e21199-eng/fyp-mechanosensor/docs/final_setup.jpeg

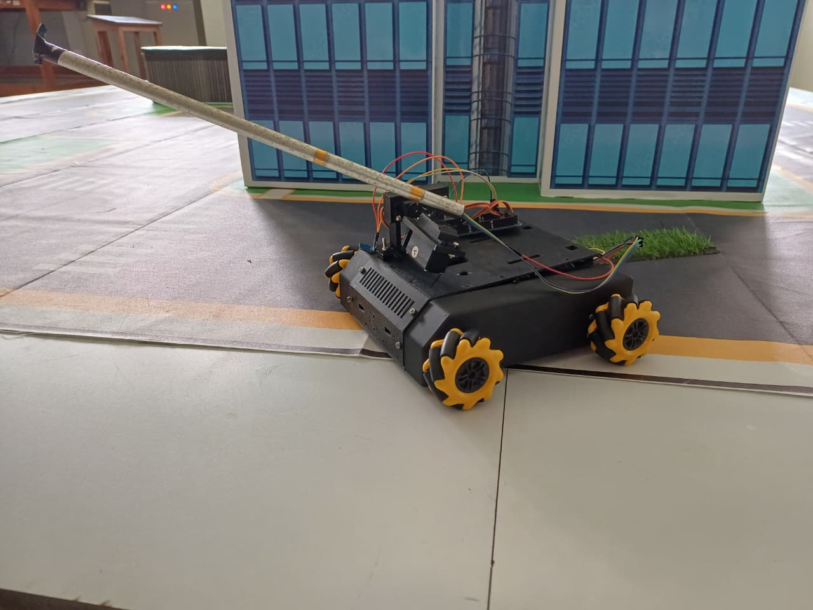
docs/final_setup.jpeg
