e21199-eng/fyp-mechanosensor/docs/assembled.jpeg

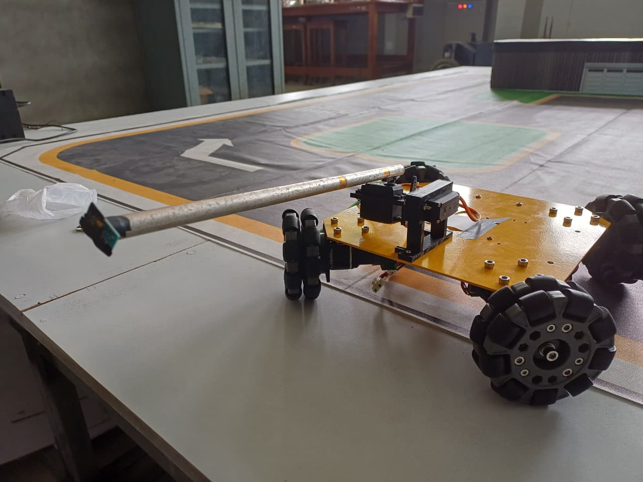
docs/assembled.jpeg
