e21199-eng/fyp-mechanosensor/README.md

# FYP Portfolio — Ego-Motion Cancellation in Vibration-Based Mechanosensors

> **Final Year Project** | Department of Engineering | 2024/2025

---

## 🤖 Project Description

In this project, a **vibration-based artificial robotic antenna**, inspired by insect antennae, is constructed using an **accelerometer mounted on the tip of a plastic tube**, and is used for detecting contacts.

The antenna is mounted on a **Pan-Tilt unit** which is then attached to a **mobile robot platform**. The key problem with this type of mechanosensor is **self-sensing due to ego-motion** vibrations from the robot's own movement interfere with contact detection. The aim is to **cancel the effects of ego-motion** using a **bio-inspired algorithm**.

---

## 🌐 Live Portfolio

👉 **[View Portfolio Website](https://e21199-eng.github.io/fyp-mechanosensor/)**

*(Replace with your actual GitHub Pages link after deploying)*

---

## 📅 Project Timeline (14 Weeks)

| Activity | Weeks |
|---|---|
| Literature Review | Week 1–2 |
| Component Research & Acquisition | Week 3 |
| Hardware Design & Schematic Drafting | Week 4–5 |
| Coding & Logic Framework Development | Week 6–9 |
| Hardware Assembly & Integration | Week 7–9 |
| Hardware Calibration | Week 10–11 |
| Offline Data Testing & Model Training | Week 11–12 |
| Performance Evaluation & Refinement | Week 13–14 |

---

## 📦 Deliverables

| # | Deliverable | Due |
|---|---|-----|
| 1 | Literature Review Summary | Week 3 |
| 2 | Hardware Components & Procurement List | Week 4 |
| 3 | PCB Schematics & Design Files | Week 6 |
| 4 | Initial Coding Framework | Week 9 |
| 5 | Assembled Mechanosensor Prototype | Week 10 |
| 6 | Calibration & Sensitivity Report | Week 11 |
| 7 | Offline Testing Analysis Report | Week 14 |

---

## 🗂️ Repository Structure

```
fyp-portfolio/
├── index.html          ← Main portfolio website
├── css/
│   ├── style.css       ← Custom styles
│   └── bootstrap.min.css
├── js/
│   └── main.js         ← Custom scripts
├── img/                ← Add your project images here
├── lib/                ← Animation & UI libraries
└── README.md
```

---

## 🚀 How to Deploy on GitHub Pages

1. Push this folder to your GitHub repository
2. Go to **Settings → Pages**
3. Source: **Deploy from branch → main → / (root)**
4. Your site will be live at: `https://YOUR_USERNAME.github.io/REPO_NAME/`

---

## 🛠️ How to Update Weekly Progress

Each week, open `index.html` and find the **Weekly Updates** section.

Change the status of each week's card:
- `status-completed` — work done ✅
- `status-inprogress` — currently working 🔄
- `status-upcoming` — not started yet ⏳

Update the description text inside each `.update-body` section.

---

## 📸 Adding Your Own Images

Replace placeholder divs in `index.html` with real images:

```html
<!-- Find this comment in index.html: -->
<!-- Replace the div above with: <img class="w-100" src="img/robot-antenna.jpg" ...> -->

<!-- Simply add your image to the img/ folder and update the src path -->
```

---

## 📬 Contact

| Jayasundara J.P. | E/21/199 |
| Divyanga D.H.S. | E/21/117 |
| Kariyawasam N.G.V.K. | E/21/212 |

**Supervisors:** Dr. B.G.L.T. Samaranayake, Dr. W.A.N.I. Harischandra
**University:** University of Peradeniya — Faculty of Engineering
**Email:** e21199@eng.pdn.ac.lk

---

*Portfolio built using the Coraluxe HTML template, adapted for FYP use.*
