e21199-eng/fyp-mechanosensor/docs/accelerometer_data.jpeg

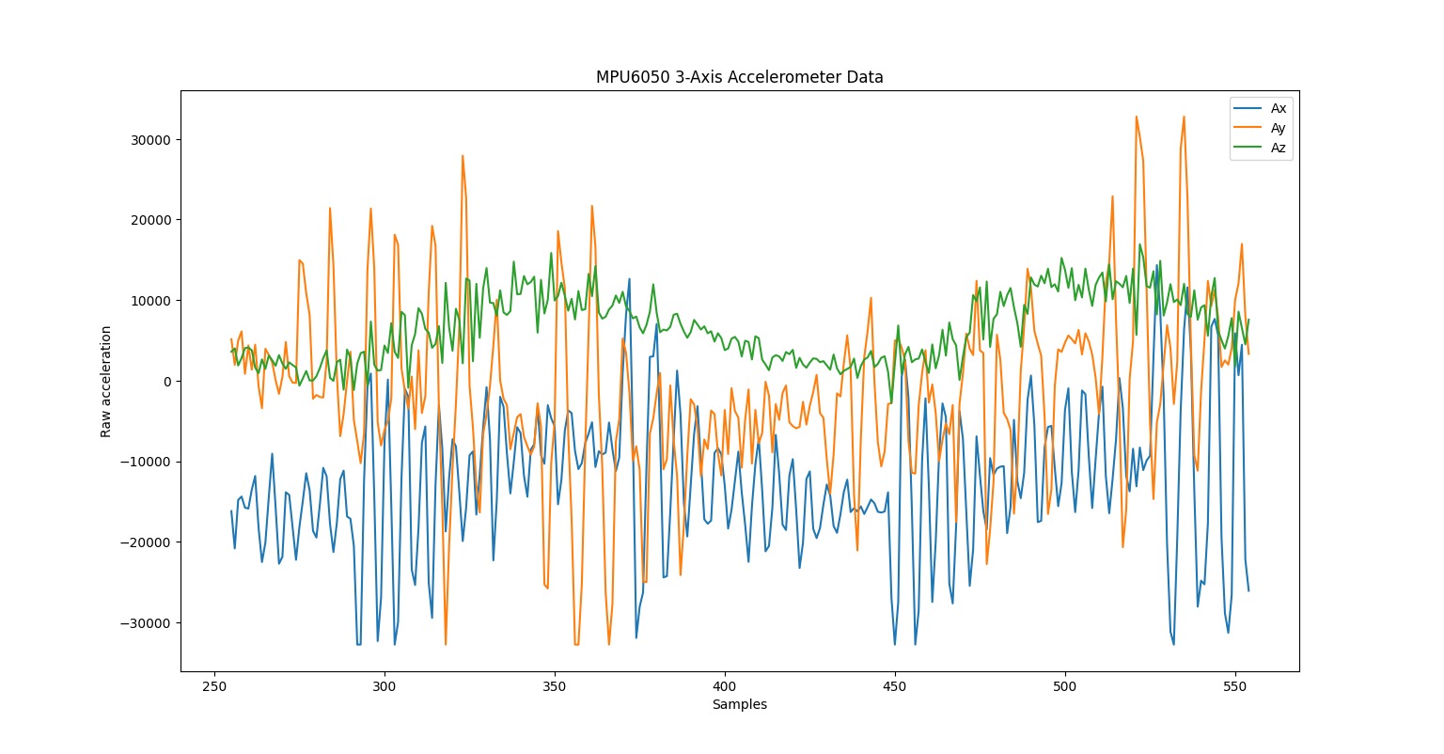
docs/accelerometer_data.jpeg
