e21199-eng/fyp-mechanosensor/docs/accelometer.jpeg

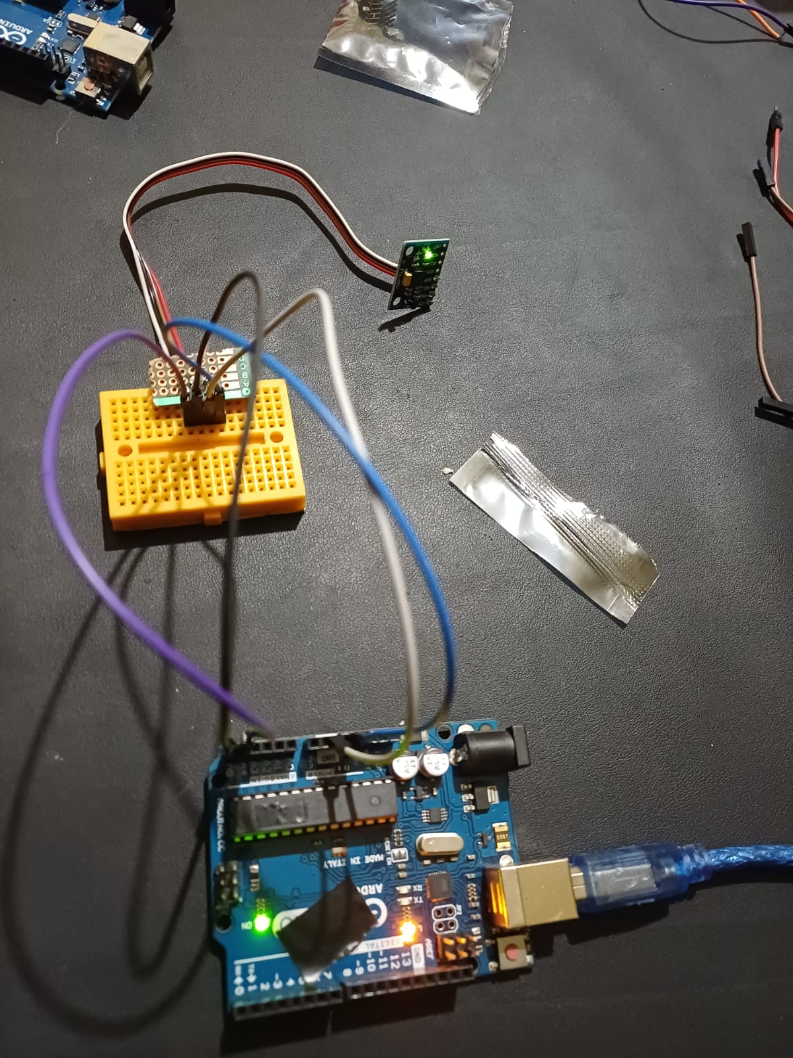
docs/accelometer.jpeg
