e21199-eng/fyp-mechanosensor/docs/Cct Diagram.jpeg

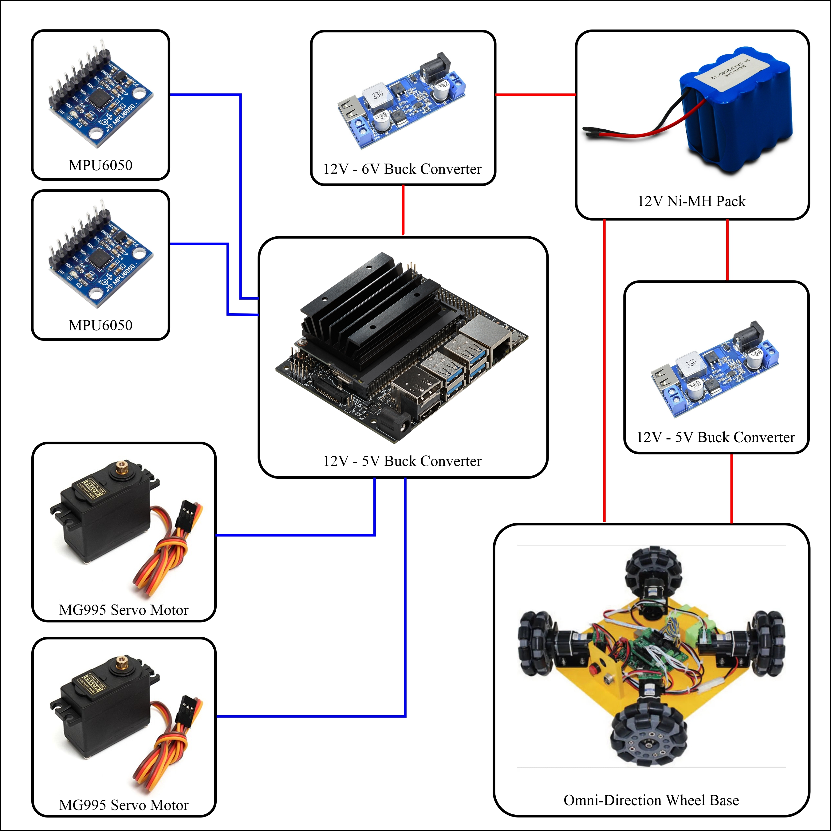
docs/Cct Diagram.jpeg
