e21199-eng/fyp-mechanosensor/docs/circuit.jpeg

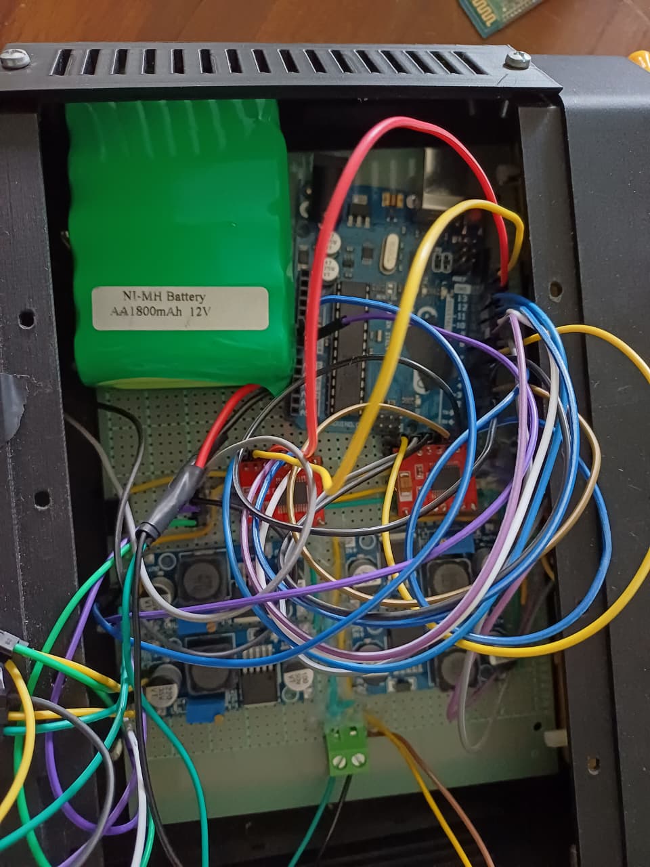
docs/circuit.jpeg
