e21199-eng/fyp-mechanosensor/docs/Circuit_Dia.jpeg

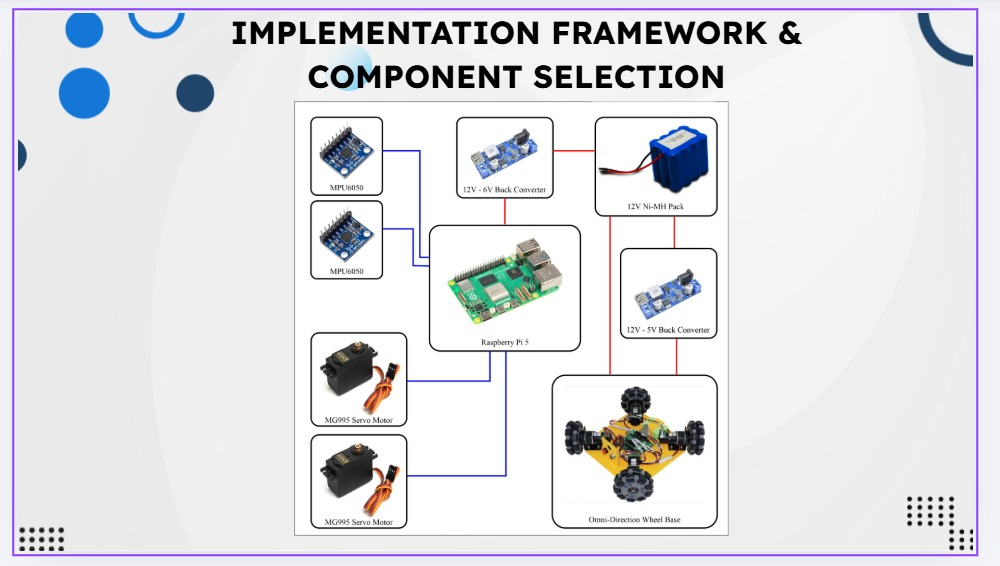
docs/Circuit_Dia.jpeg
