e21199-eng/fyp-mechanosensor/docs/Data_flow.jpeg

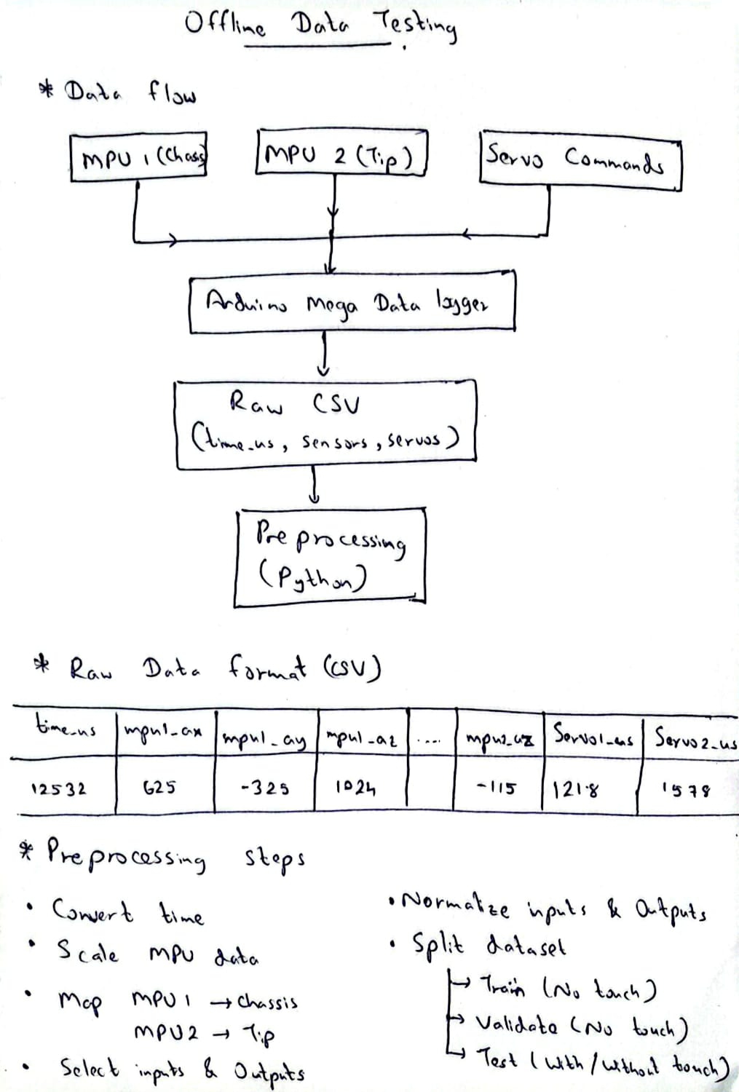
docs/Data_flow.jpeg
