e21199-eng/fyp-mechanosensor/docs/ESN1.jpeg

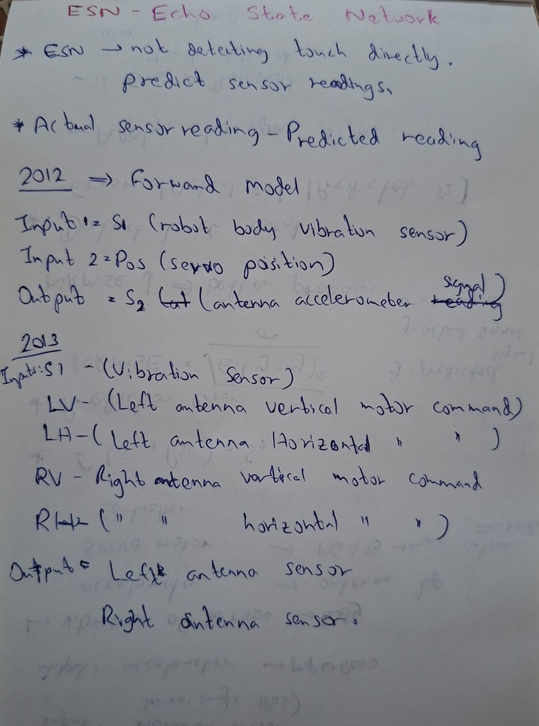
docs/ESN1.jpeg
