e21199-eng/fyp-mechanosensor/docs/ESN2.jpeg

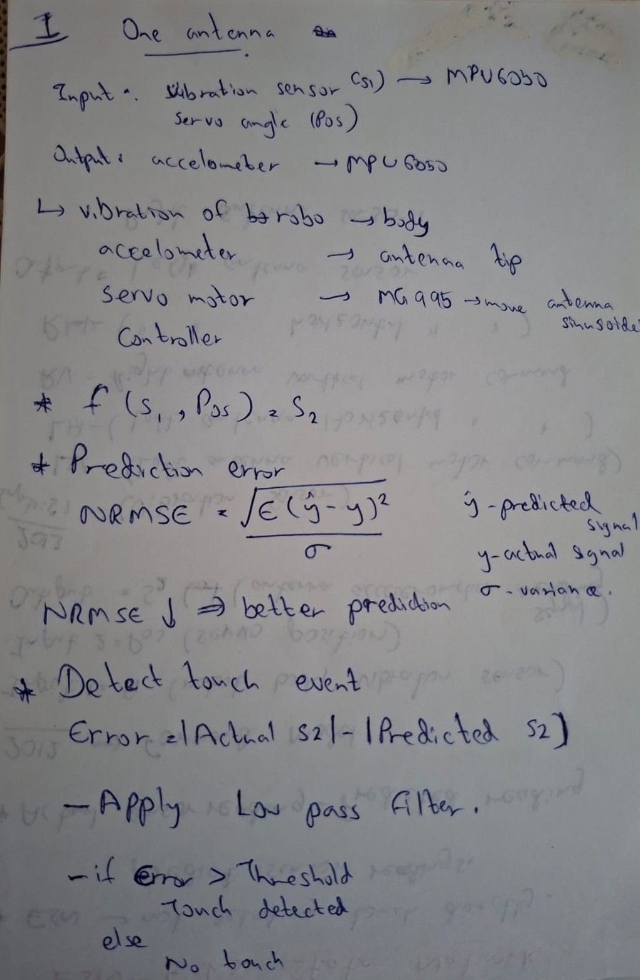
docs/ESN2.jpeg
