e21199-eng/fyp-mechanosensor/docs/ESN3.jpeg

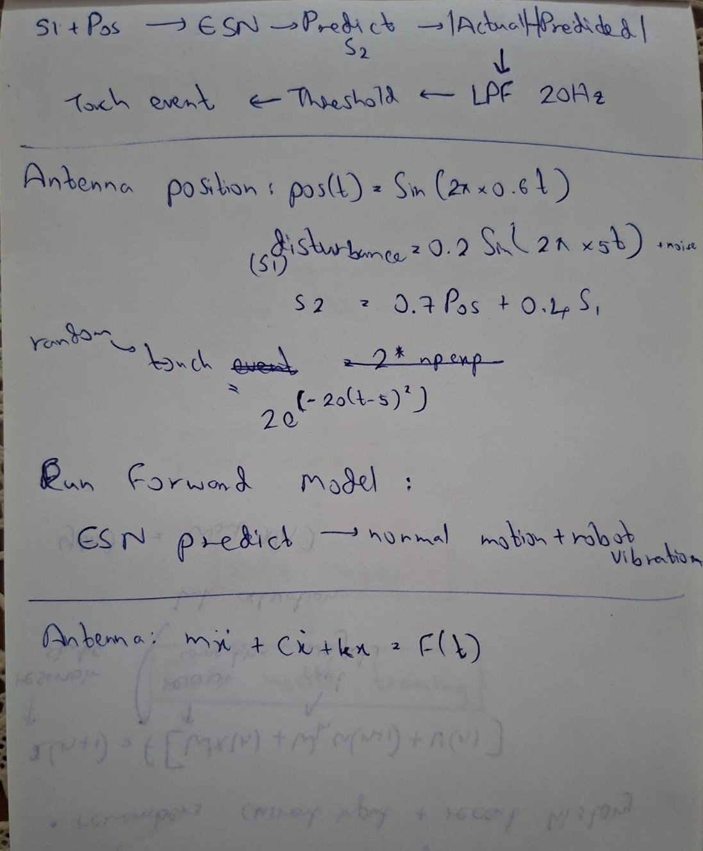
docs/ESN3.jpeg
