e21199-eng/fyp-mechanosensor/docs/esn.png

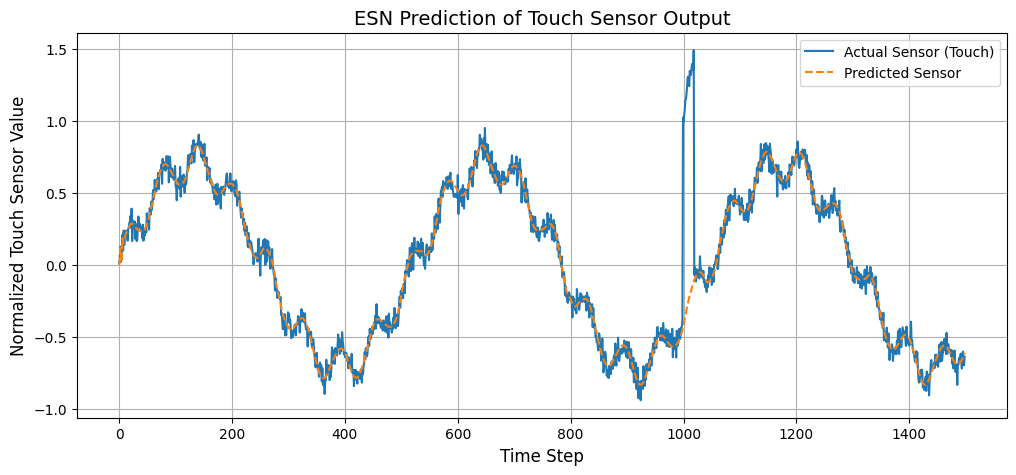
docs/esn.png
