e21199-eng/fyp-mechanosensor/docs/Hyperparameters.jpeg

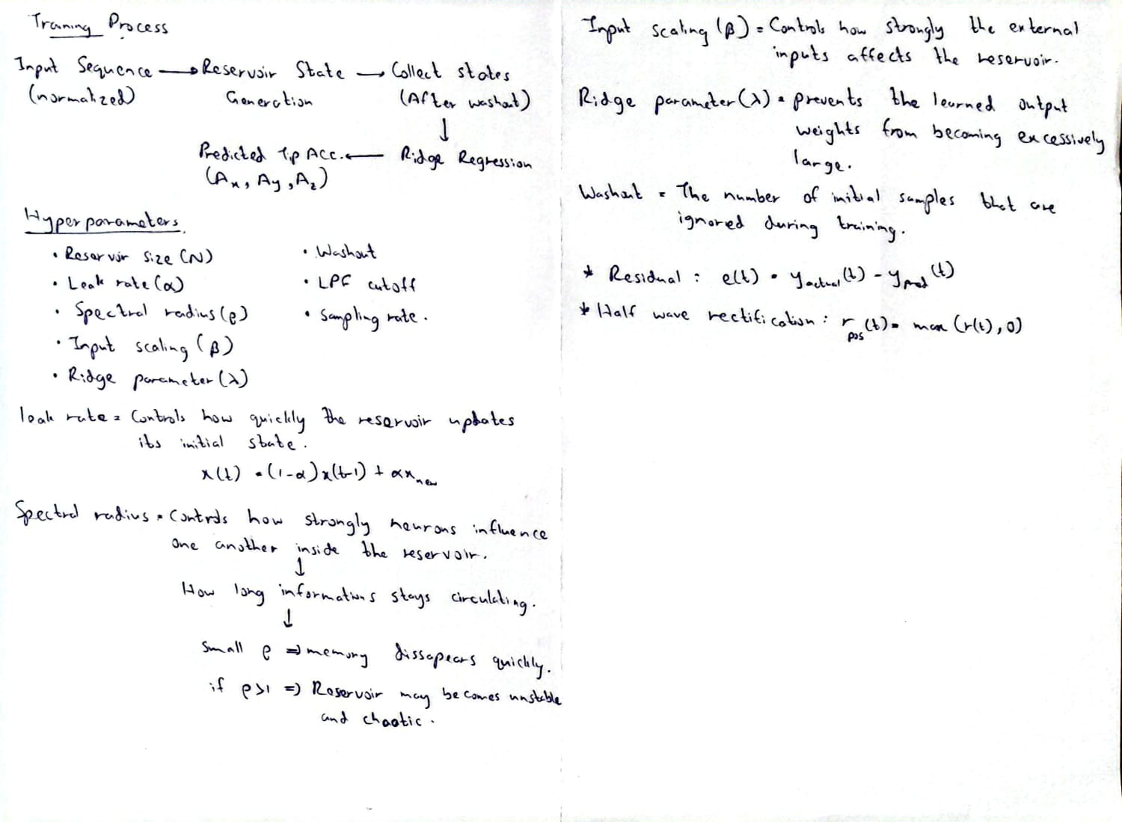
docs/Hyperparameters.jpeg
