e21199-eng/fyp-mechanosensor/docs/Kalman.jpeg

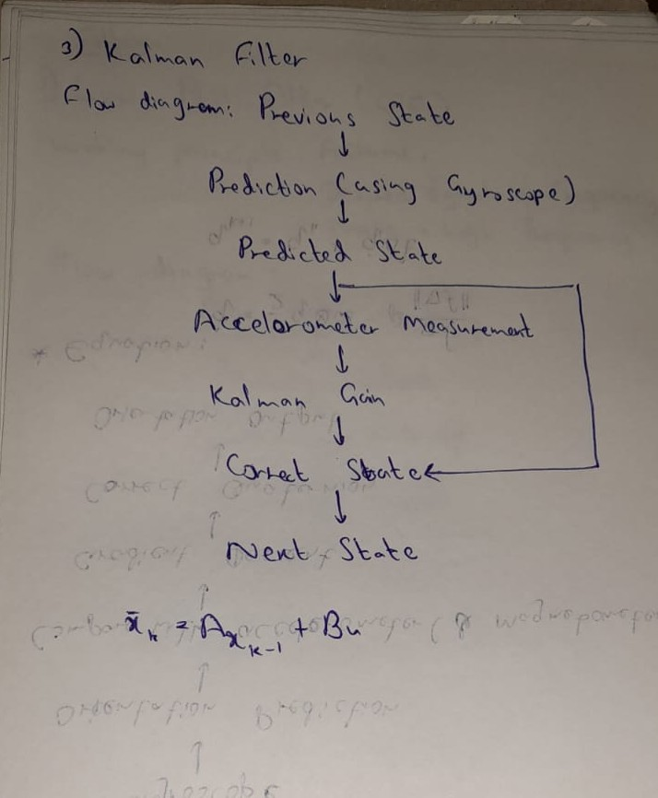
docs/Kalman.jpeg
