e21199-eng/fyp-mechanosensor/docs/LPF.jpeg

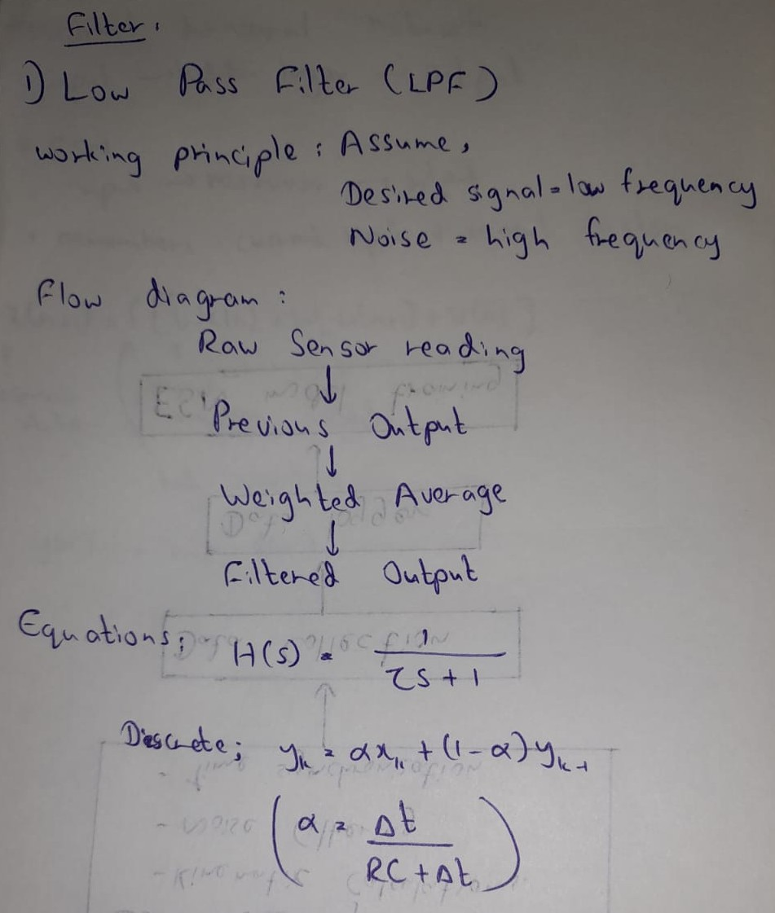
docs/LPF.jpeg
