e21199-eng/fyp-mechanosensor/docs/Madgwick.jpeg

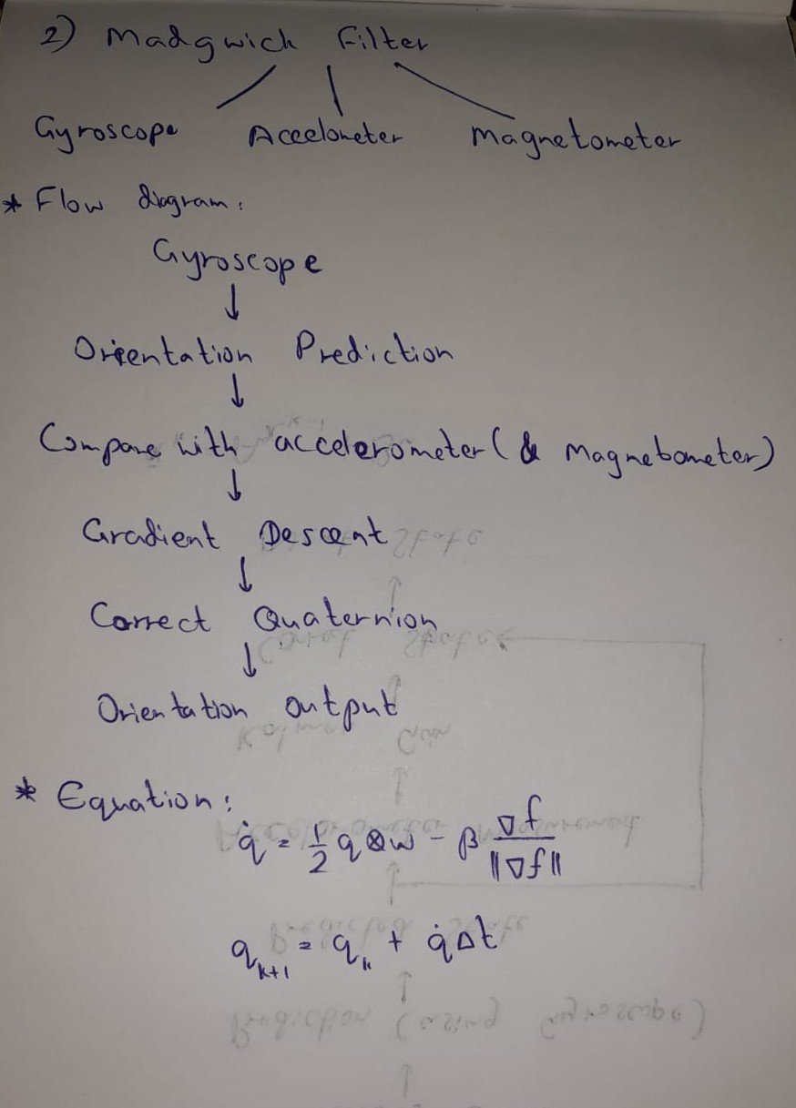
docs/Madgwick.jpeg
