e21199-eng/fyp-mechanosensor/docs/powerlines.jpeg

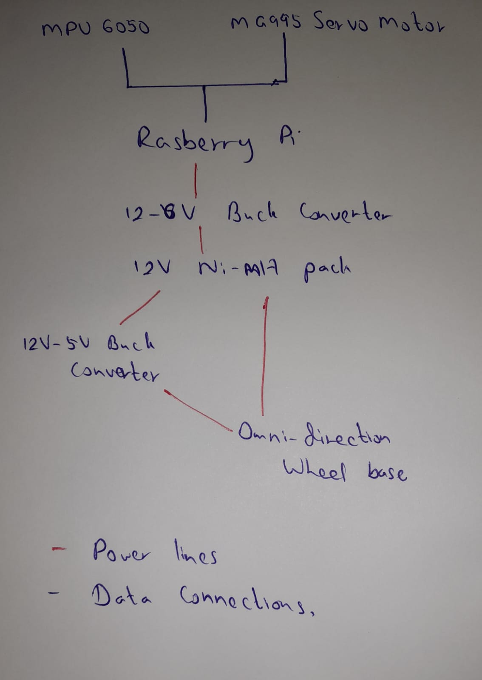
docs/powerlines.jpeg
