e21199-eng/fyp-mechanosensor/docs/Structure.jpeg

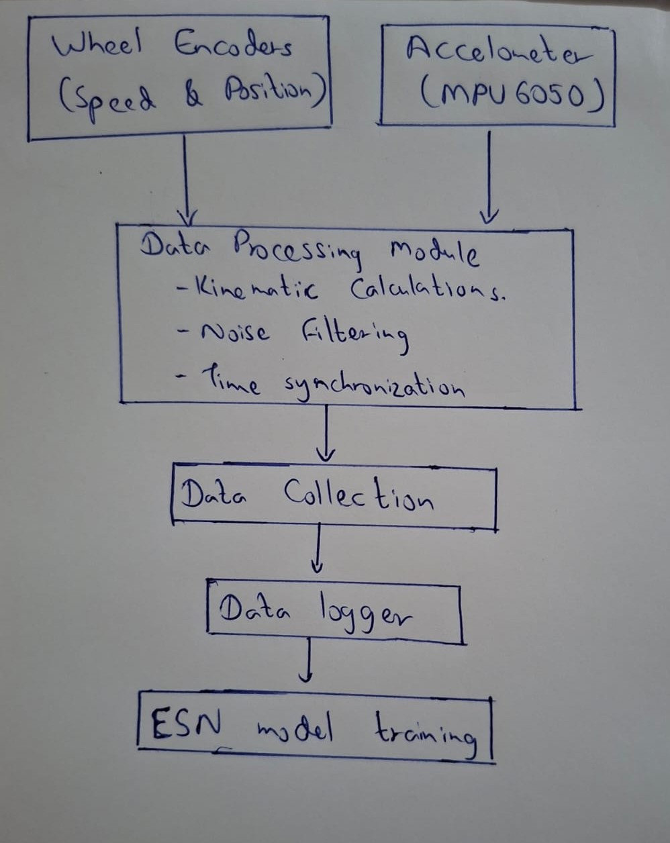
docs/Structure.jpeg
