e21199-eng/fyp-mechanosensor/hero1.jpg

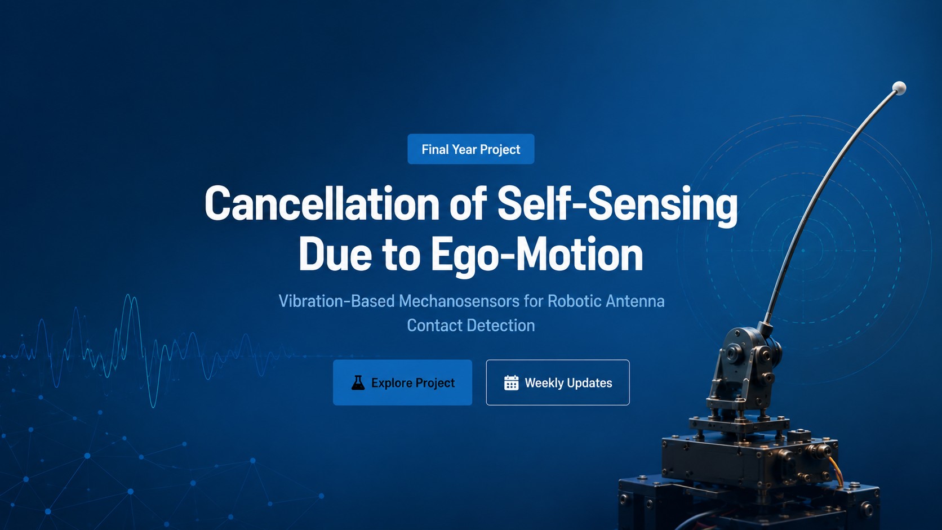
hero1.jpg
