e21199-eng/fyp-mechanosensor/hero2.jpg

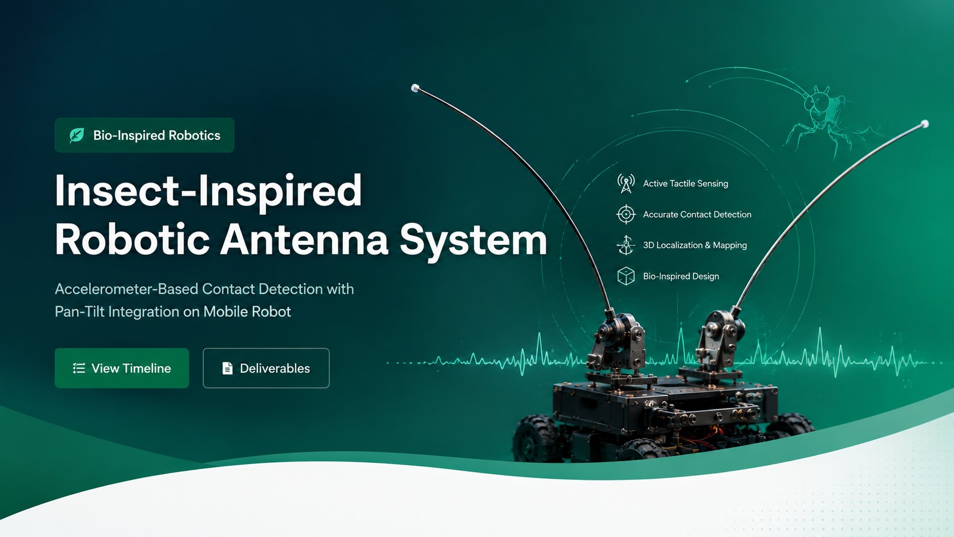
hero2.jpg
