e21199-eng/fyp-mechanosensor/member1.jpg

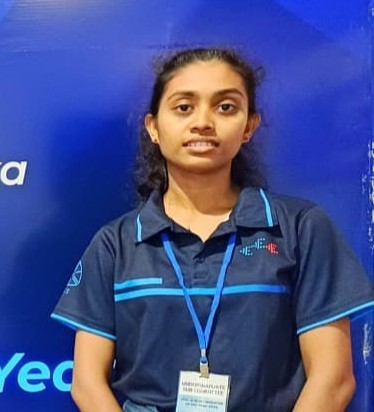
member1.jpg
