e21199-eng/fyp-mechanosensor/member2.jpg

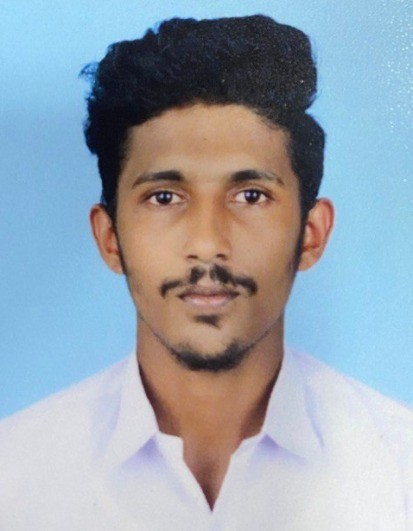
member2.jpg
