e21199-eng/fyp-mechanosensor/member3.jpg

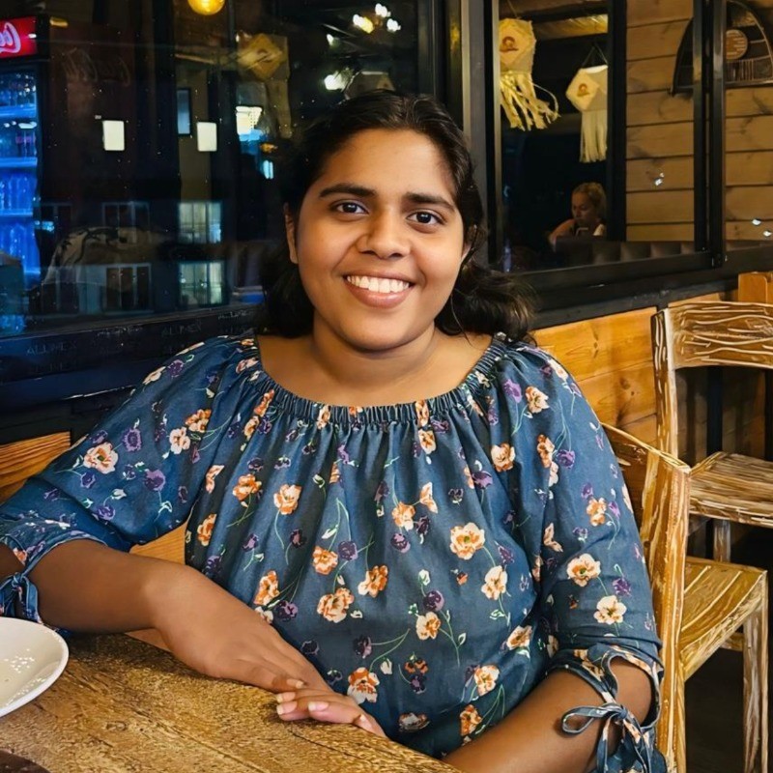
member3.jpg
