e21199-eng/fyp-mechanosensor/robo1.jpg

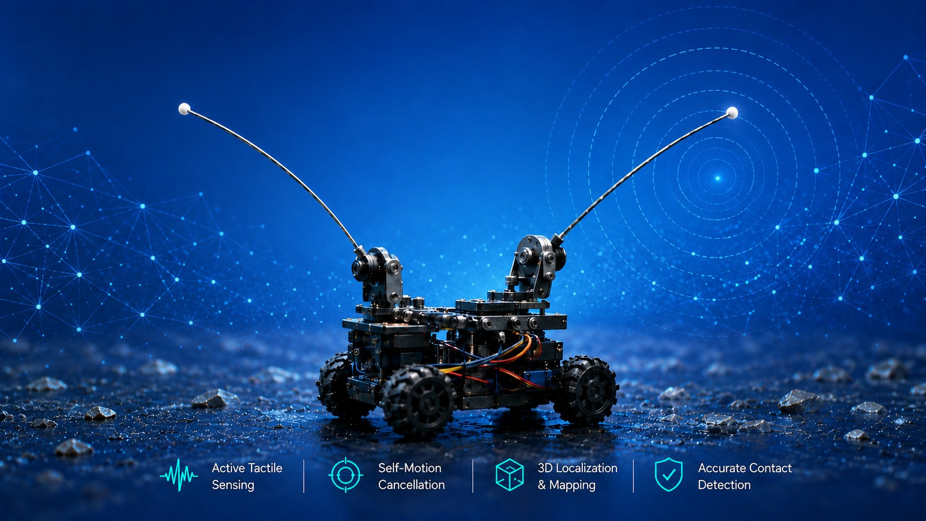
robo1.jpg
