e21199-eng/fyp-mechanosensor/supervisor1.jpg

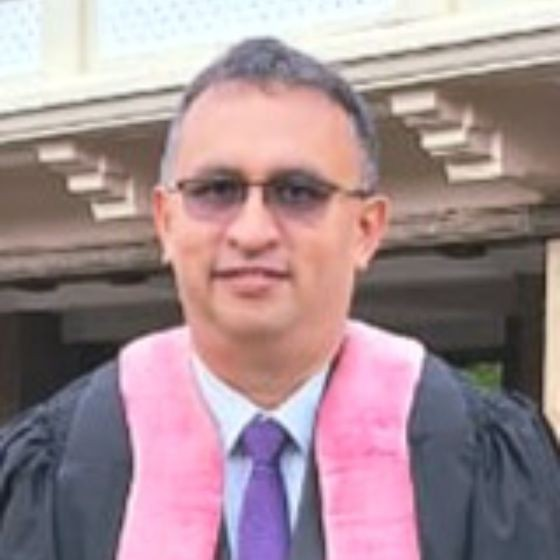
supervisor1.jpg
