e21199-eng/fyp-mechanosensor/supervisor2.jpg

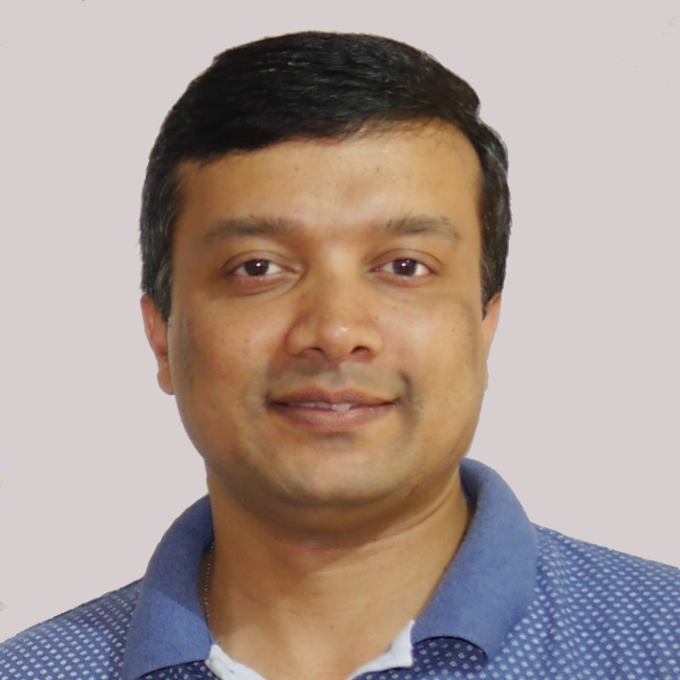
supervisor2.jpg
