e21199-eng/fyp-mechanosensor/theme1.jpg

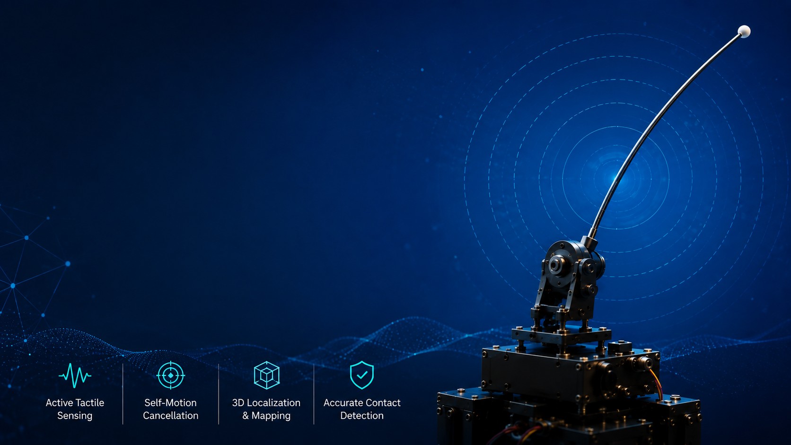
theme1.jpg
