e21199-eng/fyp-mechanosensor/theme2.jpg

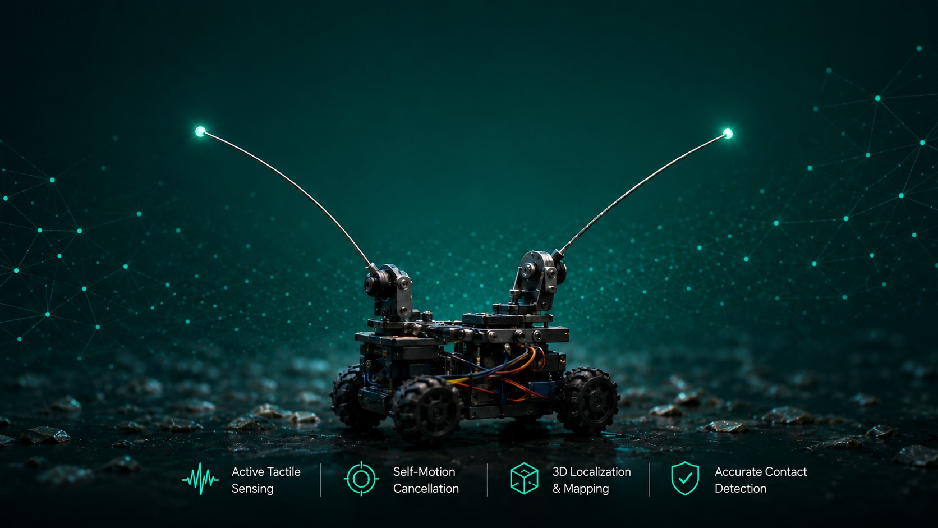
theme2.jpg
