e21199-eng/fyp-mechanosensor/docs/assembled2.jpeg

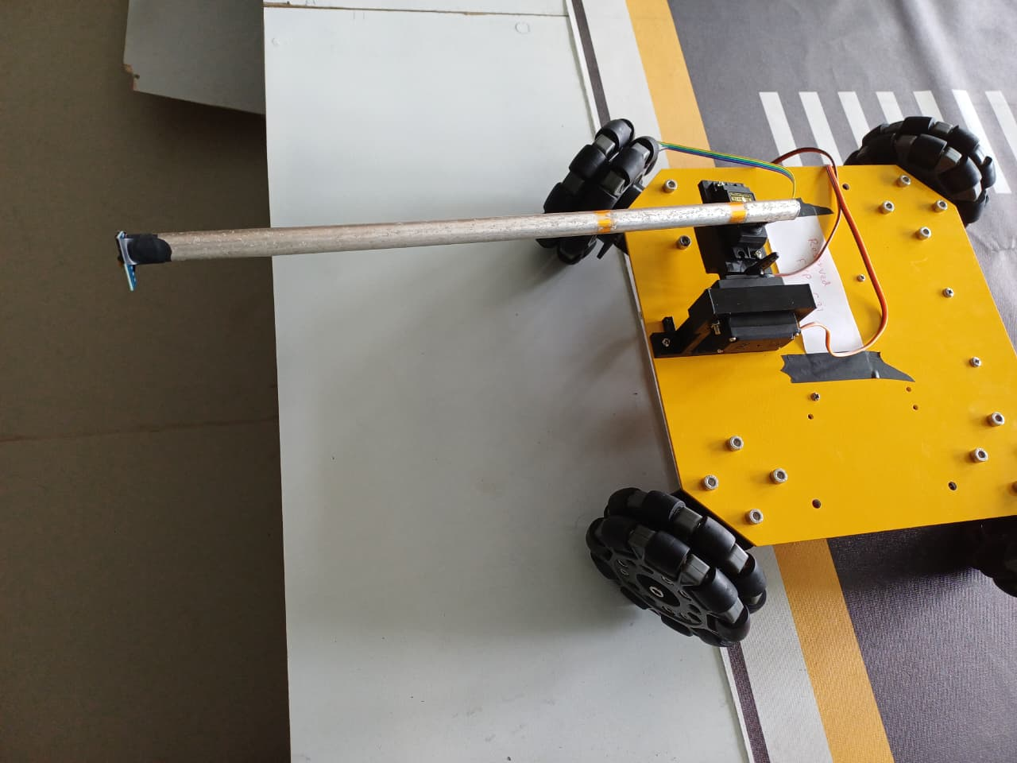
docs/assembled2.jpeg
