e21199-eng/fyp-mechanosensor/docs/Test 2 results.pdf

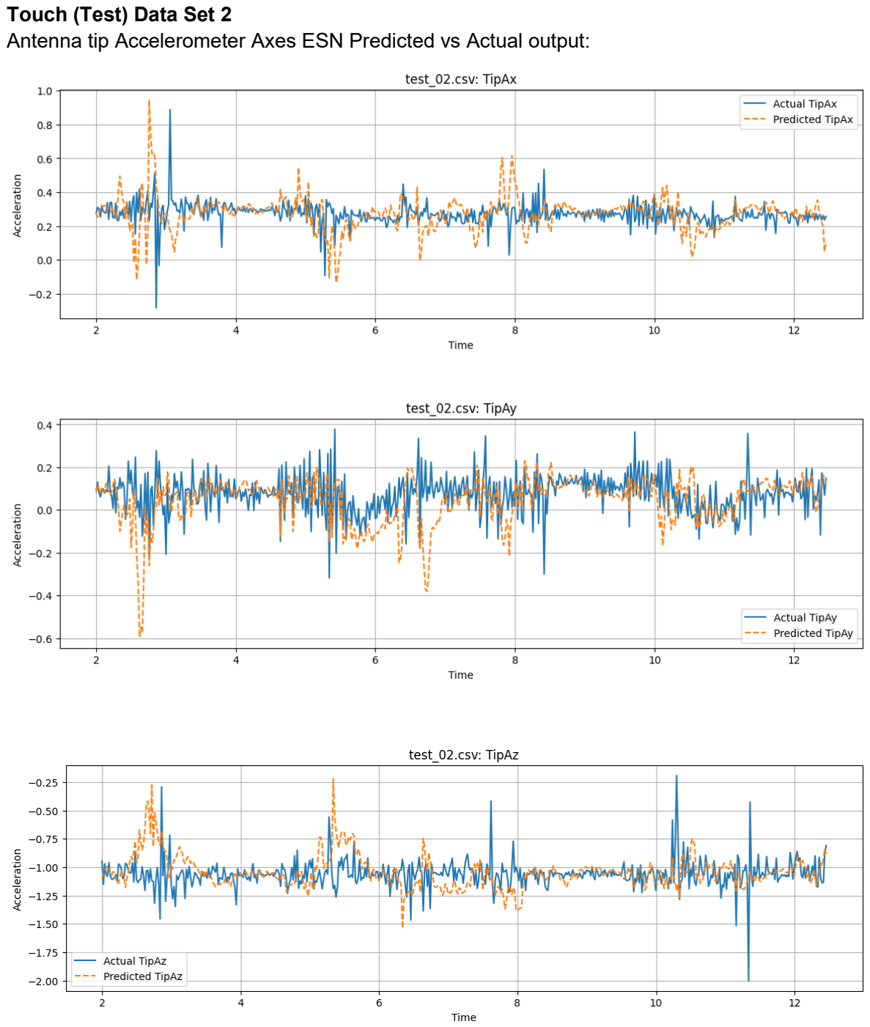
[picture p40: page 1]

Touch (Test) Data Set 2
Antenna tip Accelerometer Axes ESN Predicted vs Actual output:

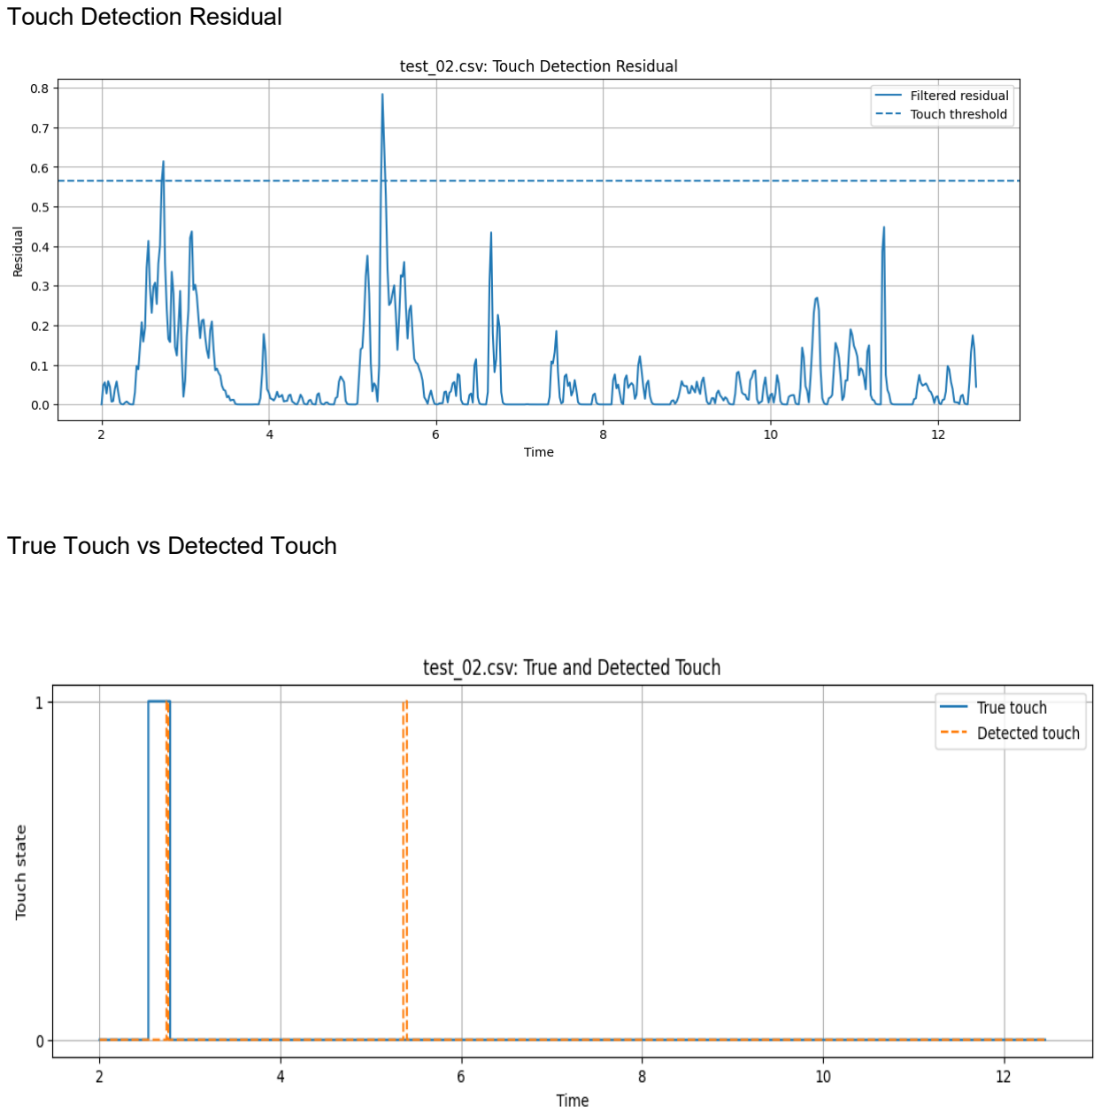
[picture p41: page 2]

Touch Detection Residual

True Touch vs Detected Touch

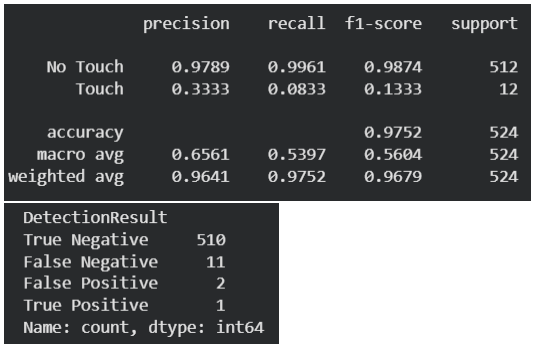
[picture p42: figure]
