e21199-eng/fyp-mechanosensor/docs/Test 3_results.pdf

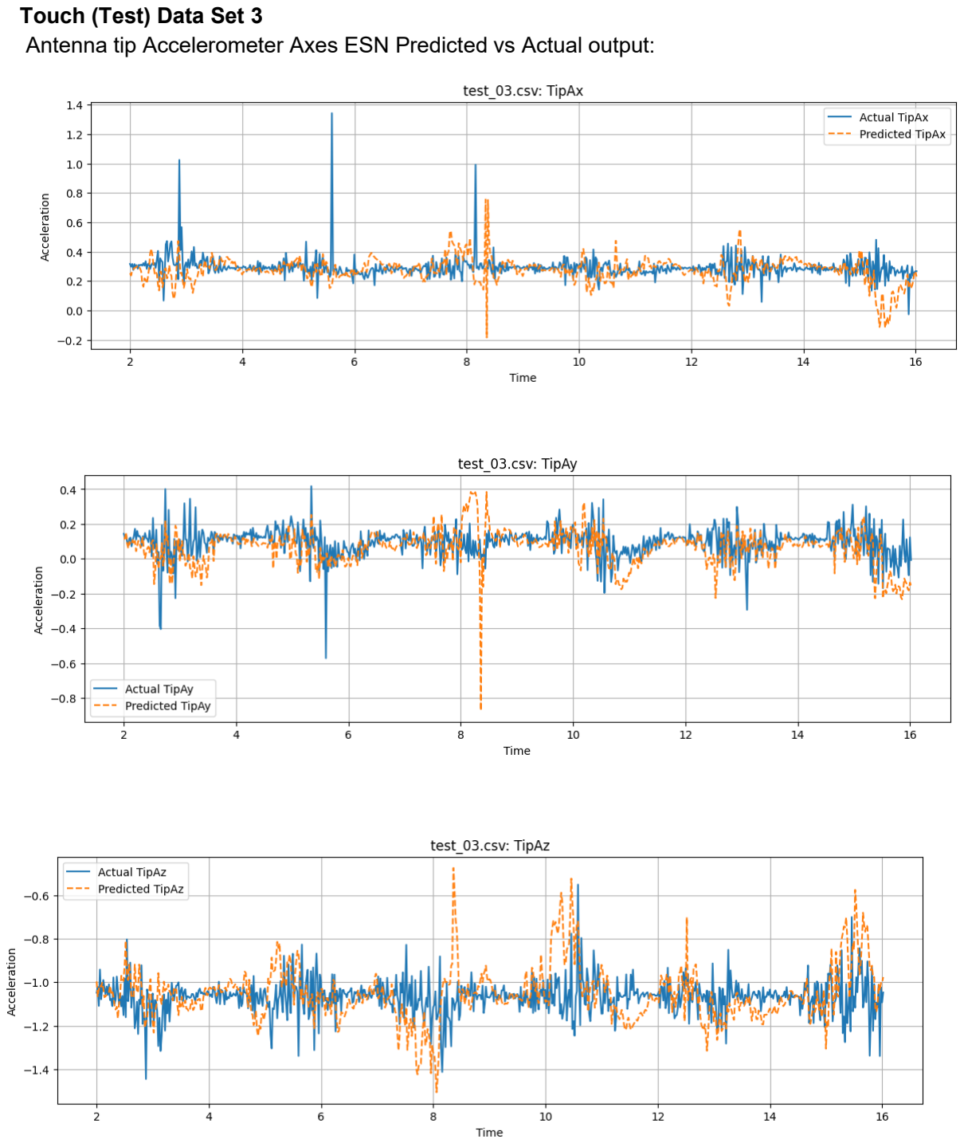
[picture p43: page 1]

Touch (Test) Data Set 3
Antenna tip Accelerometer Axes ESN Predicted vs Actual output:

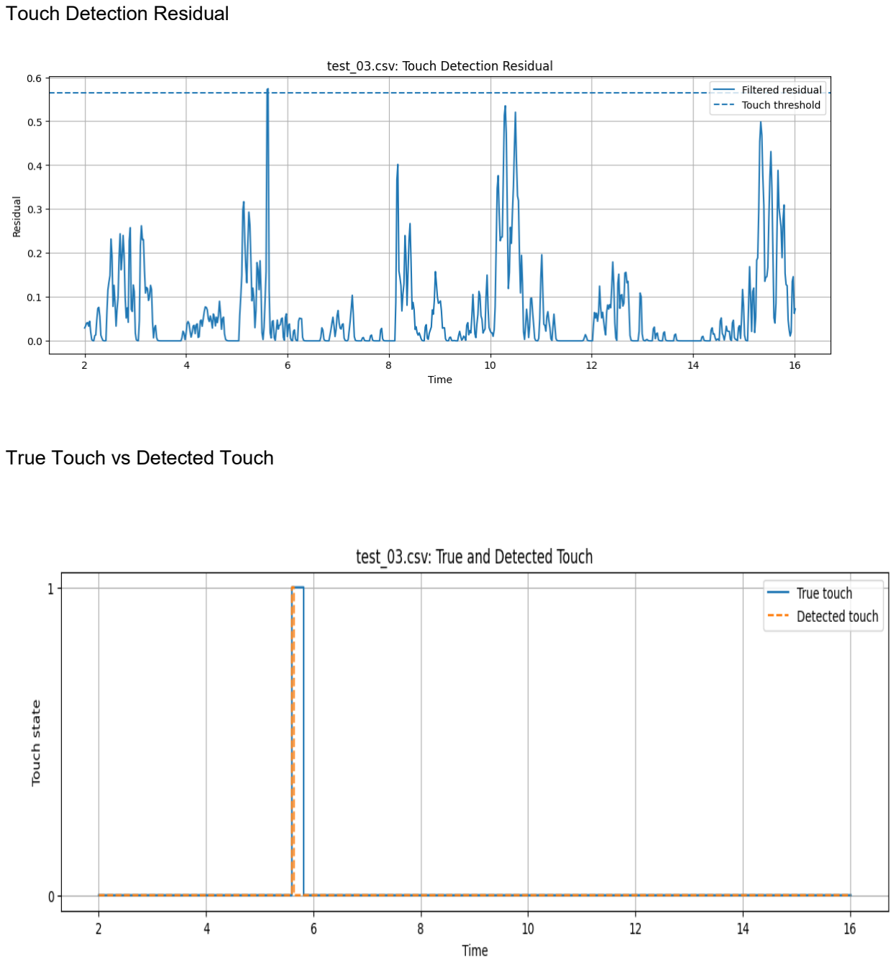
[picture p44: page 2]

Touch Detection Residual

True Touch vs Detected Touch

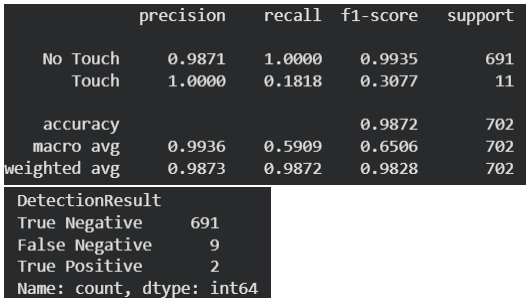
[picture p45: figure]
