e21199-eng/fyp-mechanosensor/docs/Test1_results.pdf

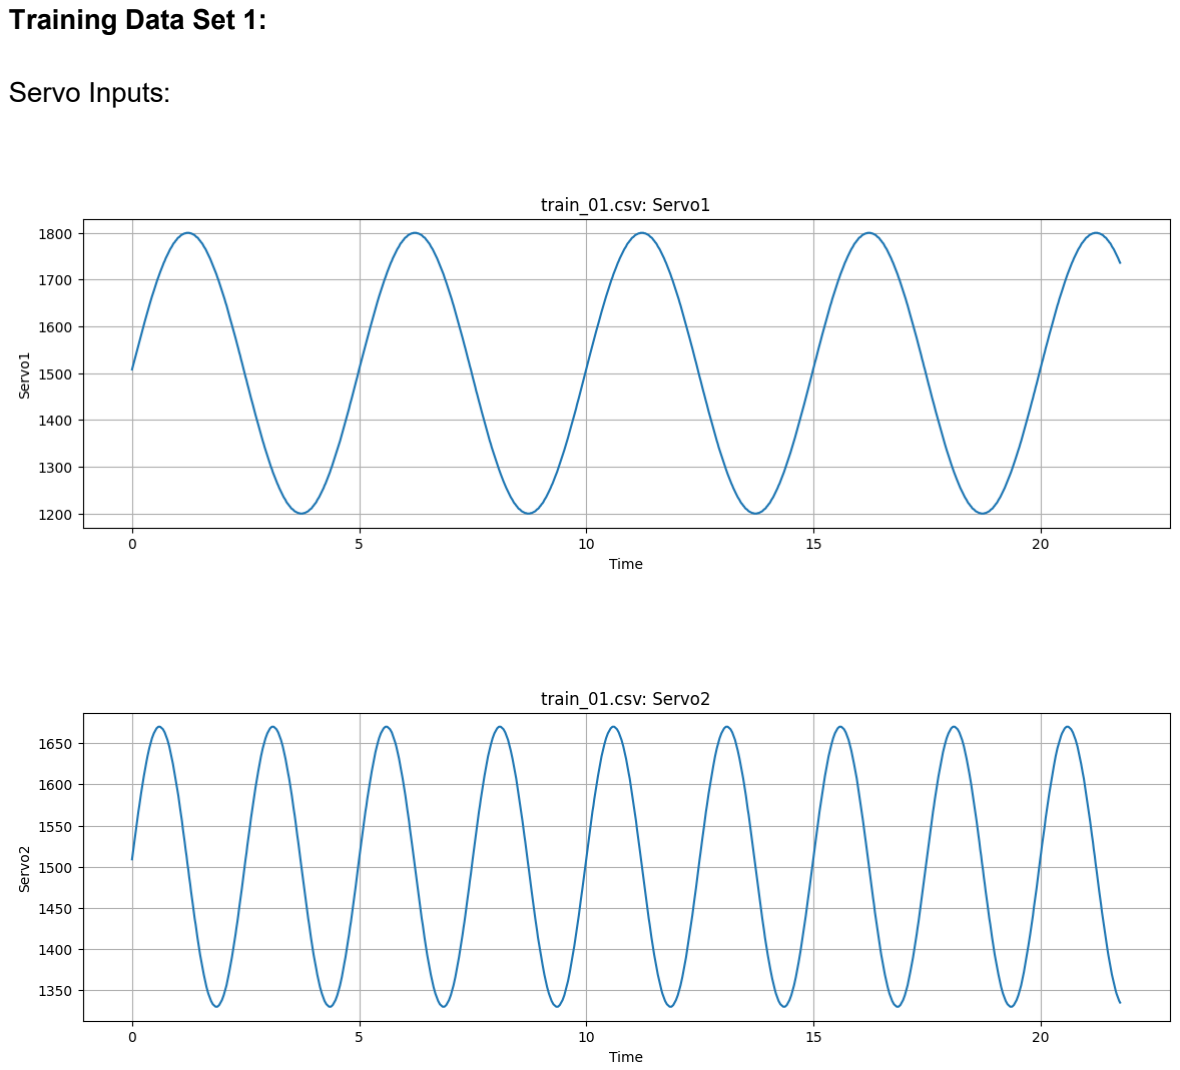
[picture p46: page 1]

Training Data Set 1:

Servo Inputs:

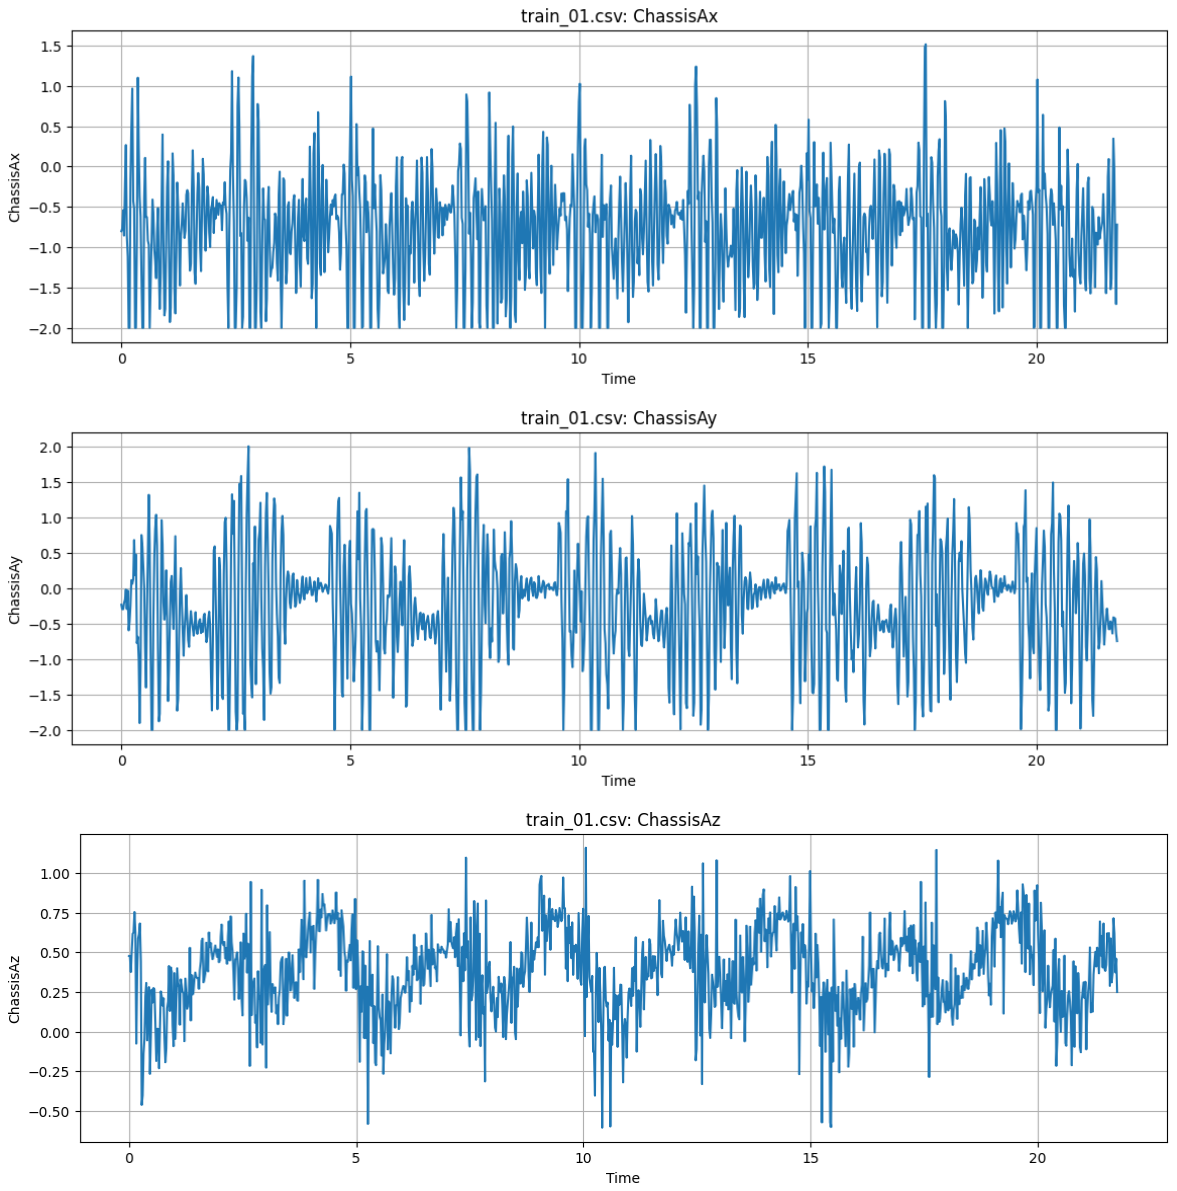
[picture p47: figure]

Chassis Accelerometer Axes:

Antenna tip Accelerometer Axes:

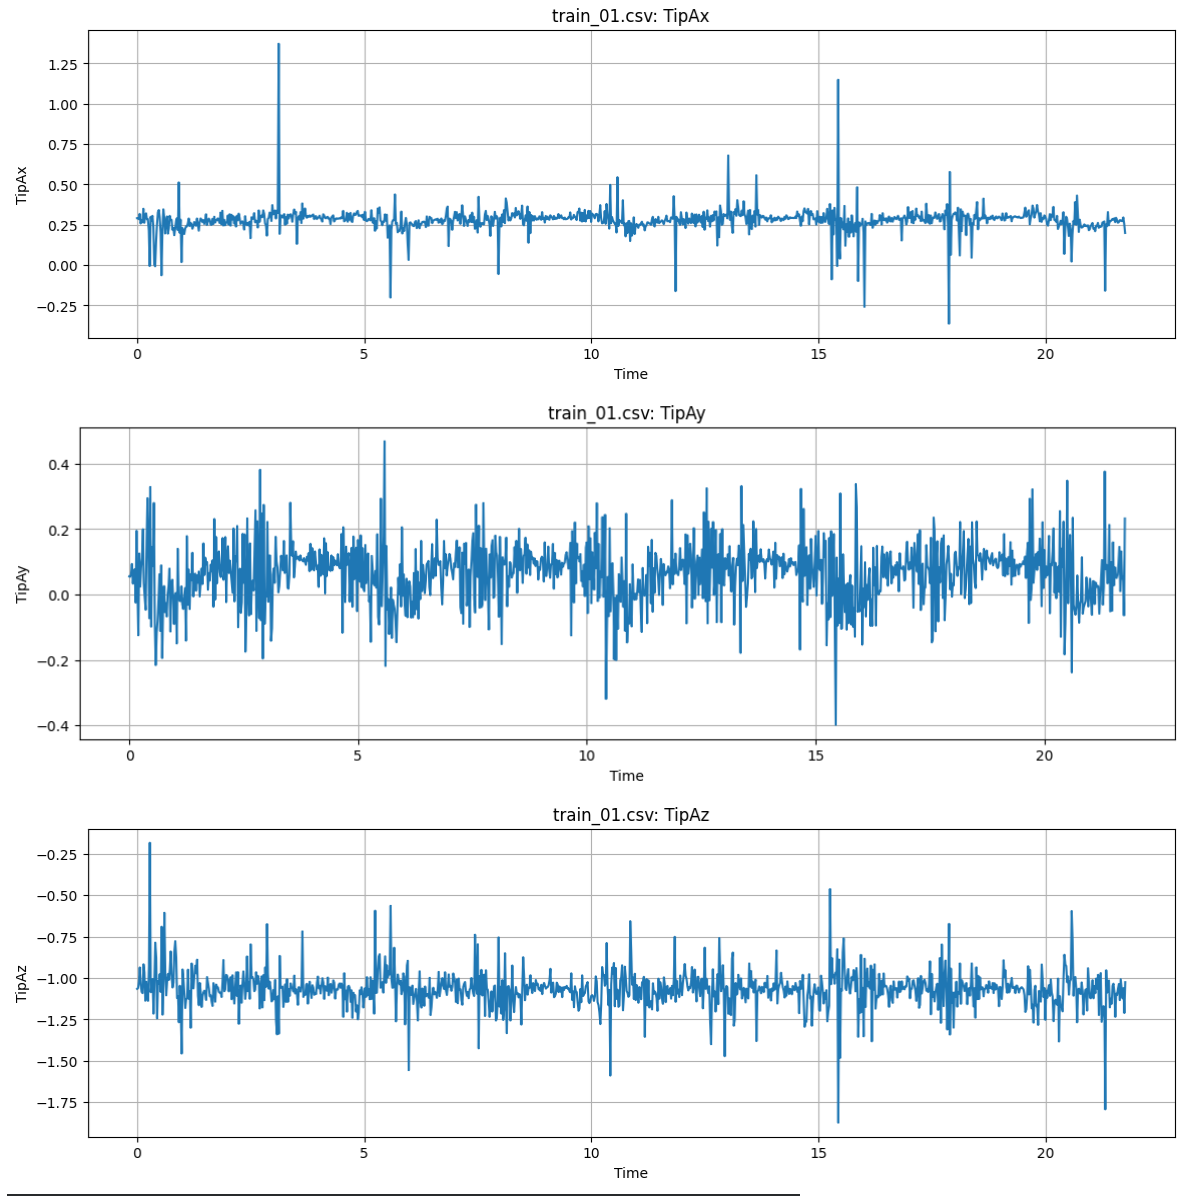
[picture p48: figure]

Selected sampling frequency: 50.000000000001066 Hz

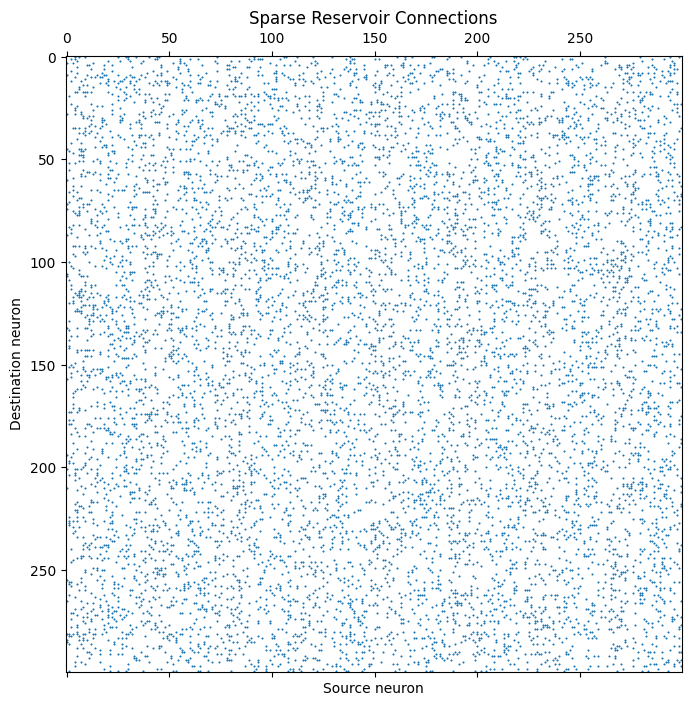
[picture p49: figure]

Validating Data Set 1:

Antenna tip Accelerometer Axes ESN Predicted vs Actual output:

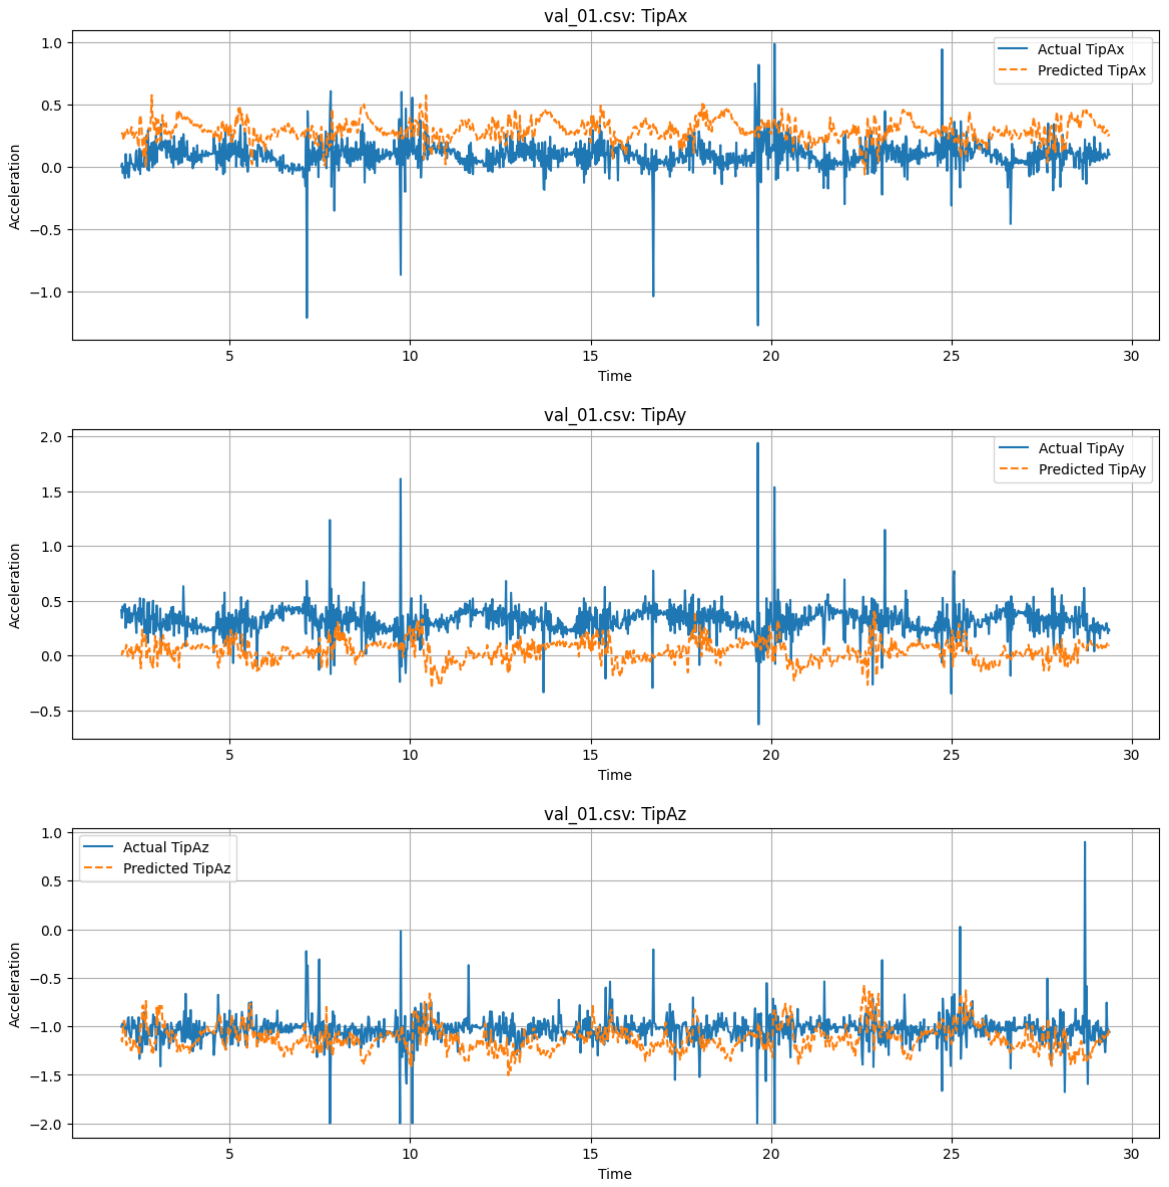
[picture p50: figure]

Touch (Test) Data Set 1
Antenna tip Accelerometer Axes ESN Predicted vs Actual output (After LPF):

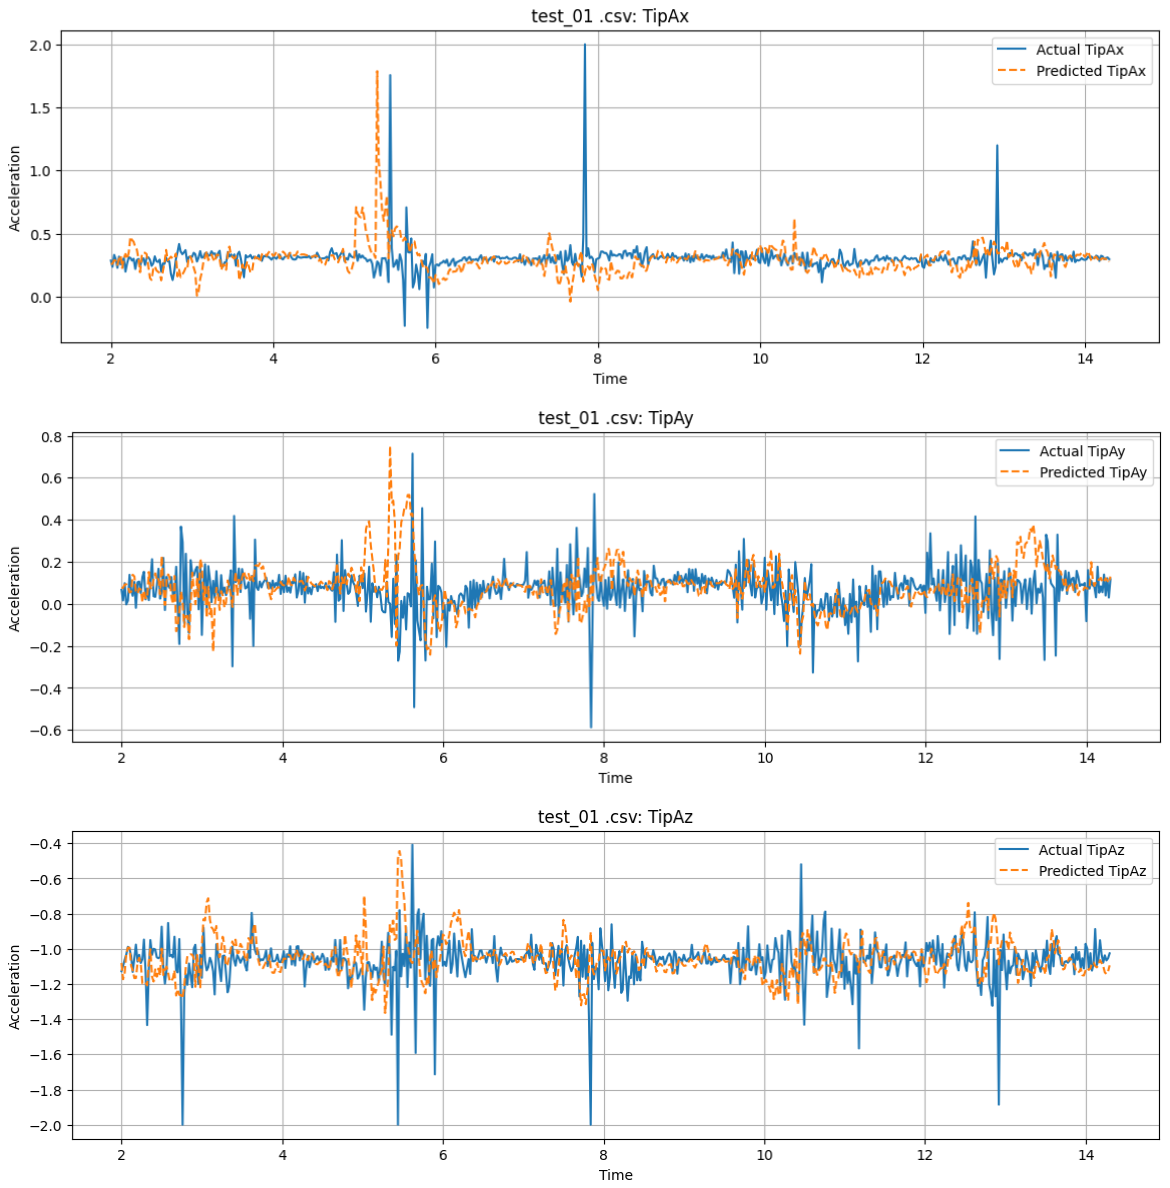
[picture p51: figure]
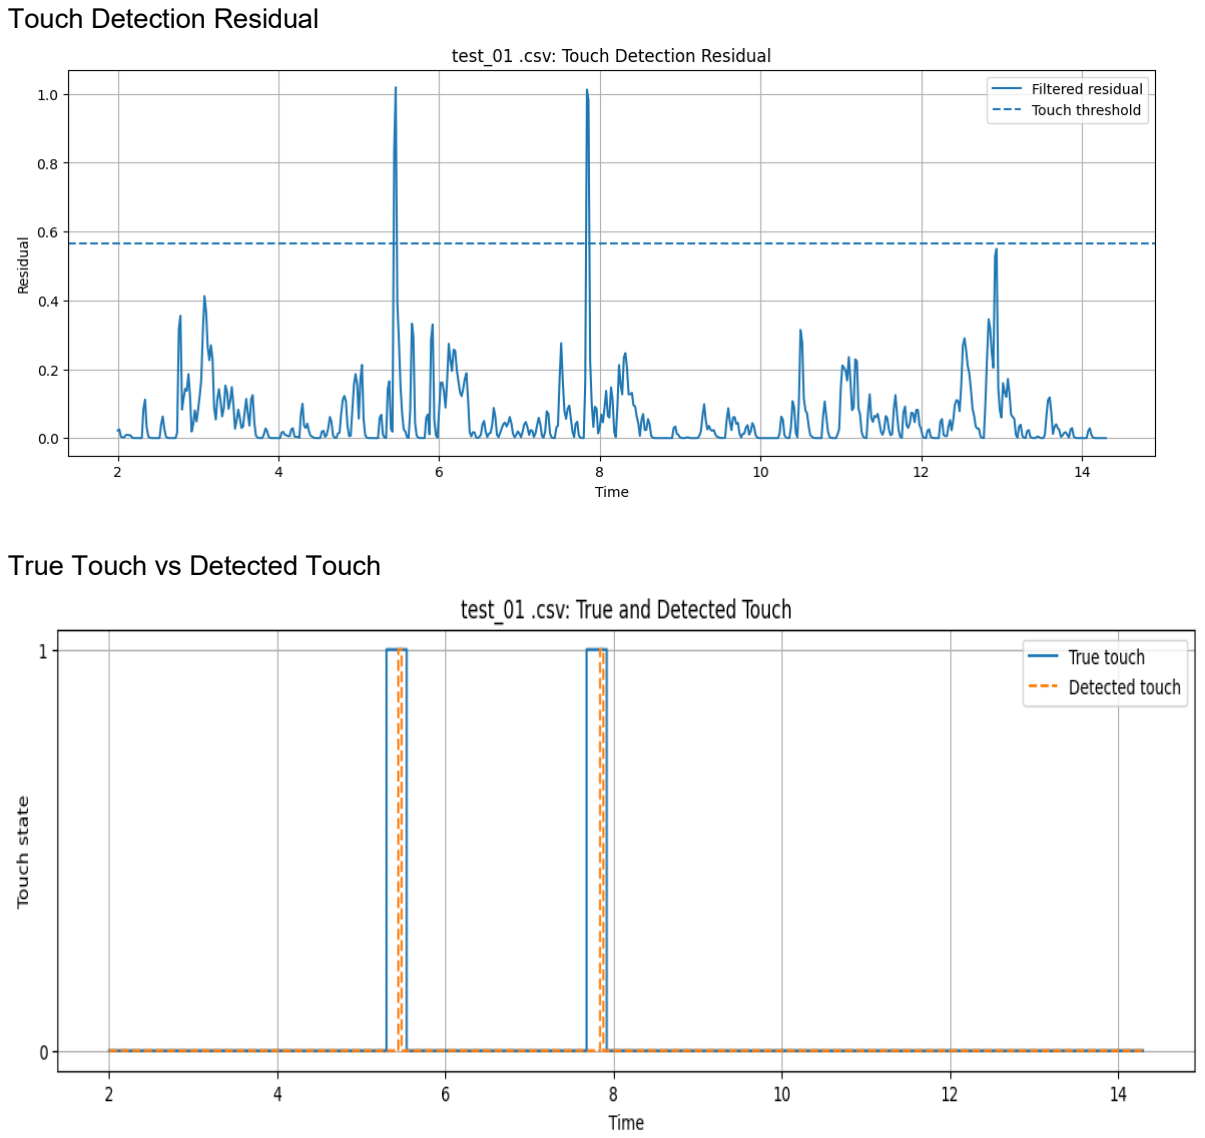
[picture p52: page 7]

Touch Detection Residual

True Touch vs Detected Touch

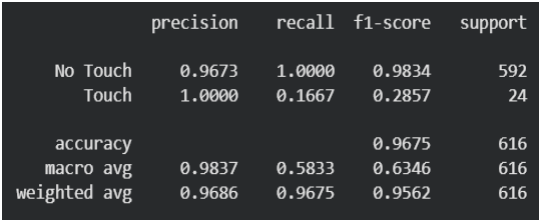
[picture p53: figure]
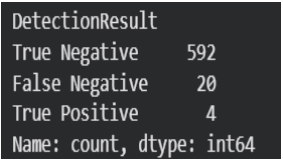
[picture p54: figure]
