e21199-eng/fyp-mechanosensor/docs/Test_4 results.pdf

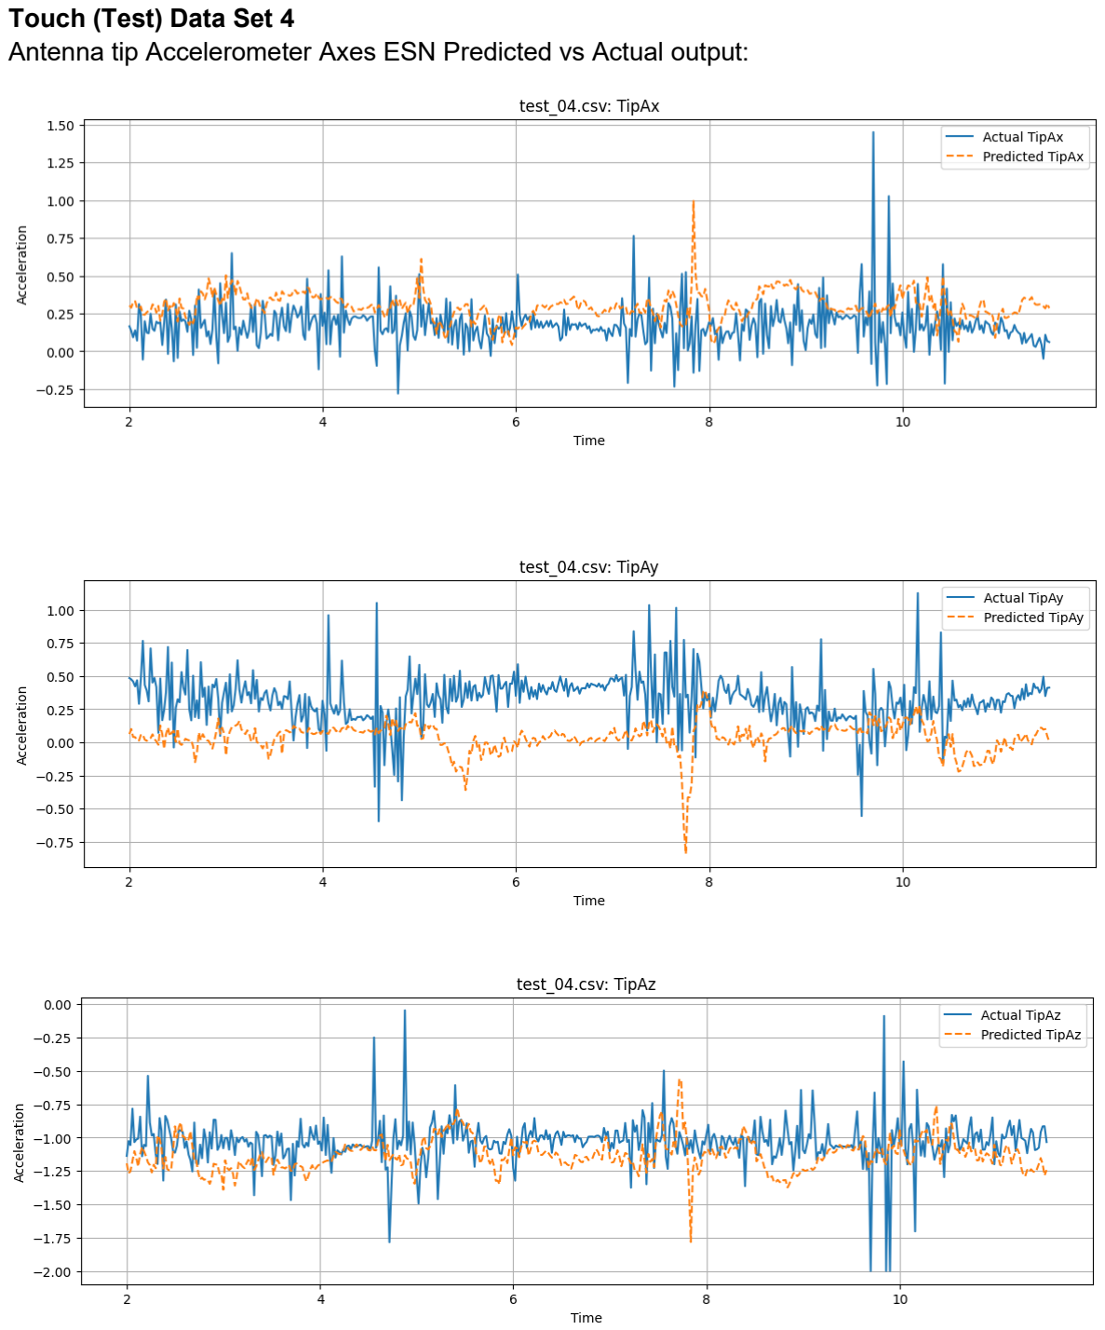
[picture p55: page 1]

Touch (Test) Data Set 4
Antenna tip Accelerometer Axes ESN Predicted vs Actual output:

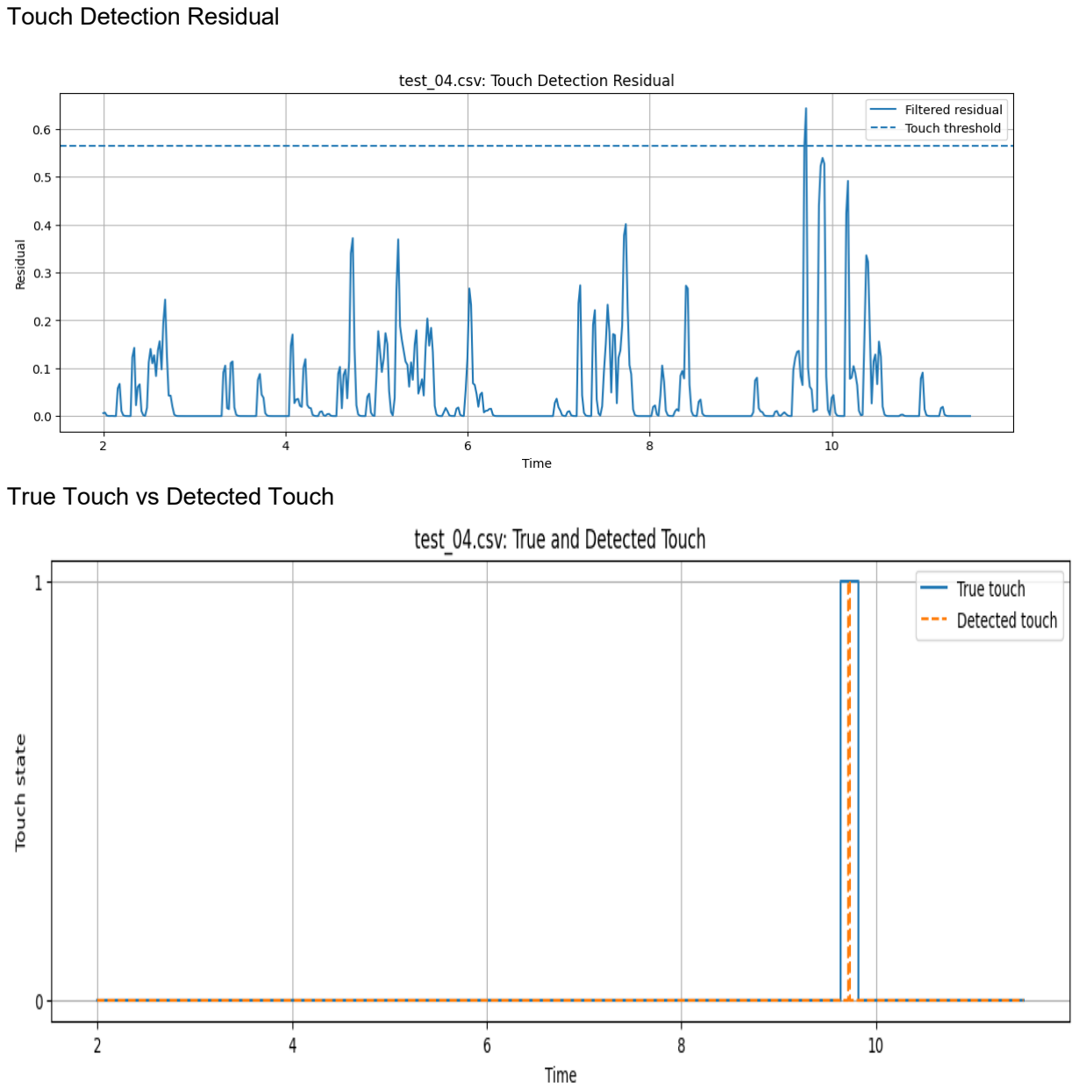
[picture p56: page 2]

Touch Detection Residual

True Touch vs Detected Touch

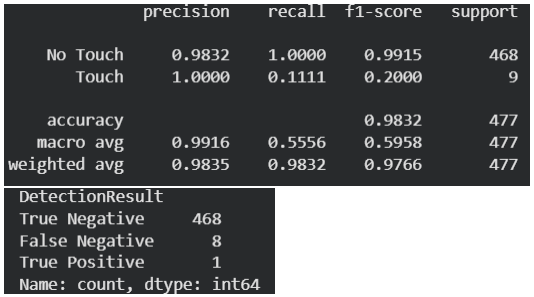
[picture p57: figure]
