e21199-eng/fyp-mechanosensor/docs/validation_data/val_01.csv

mega_time_ms | esp_time_ms | servo1_us | servo2_us | esp_ax | esp_ay | esp_az | esp_gx | esp_gy | esp_gz | gy87_ax | gy87_ay | gy87_az | gy87_gx | gy87_gy | gy87_gz | Touch
1945 | 1541 | 1508 | 1509 | -13660 | -2552 | 7892 | -355 | 25 | 79 | 2040 | 4988 | -17072 | -393 | 103 | -16 | 0
1966 | 1561 | 1515 | 1517 | -14532 | -2756 | 7812 | -369 | -126 | 52 | 2128 | 5164 | -16936 | -328 | 147 | -122 | 0
1985 | 1581 | 1523 | 1526 | -13688 | -2876 | 9376 | -756 | -1297 | 510 | 2112 | 5680 | -17000 | -307 | 53 | 122 | 0
2006 | 1601 | 1530 | 1534 | -12204 | -2812 | 7416 | -138 | -329 | -290 | 1756 | 5076 | -17628 | -535 | 143 | -20 | 0
2025 | 1621 | 1538 | 1542 | -11032 | -2800 | 8176 | -70 | -202 | 63 | 1760 | 5048 | -16776 | -254 | 96 | 1191 | 0
2045 | 1641 | 1545 | 1550 | -2644 | -2680 | 7908 | -755 | -2723 | -48 | 2776 | 4832 | -16436 | 604 | 1267 | 2559 | 0
2065 | 1661 | 1553 | 1559 | 10136 | -4884 | 5452 | -2 | 5253 | 1620 | 1980 | 5472 | -16576 | -395 | 1978 | 3433 | 0
2085 | 1681 | 1560 | 1567 | -10344 | -2632 | 5640 | 1203 | 13658 | 5643 | 1924 | 1684 | -14836 | -1343 | 3330 | 5796 | 0
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
