e21199-eng/fyp-mechanosensor/docs/ESN_results/test_01  (2)_esn_results.csv

SourceFile | Time | Servo1 | Servo2 | ChassisAx | ChassisAy | ChassisAz | ActualTipAx | ActualTipAy | ActualTipAz | PredictedTipAx | PredictedTipAy | PredictedTipAz | ResidualAx | ResidualAy | ResidualAz | ResidualMagnitude | RawTouchResidual | FilteredTouchResidual | TouchThreshold | TrueTouch | DetectedTouchRaw | DetectedTouch | DetectionResult
test_01 (2).csv | 2.0 | 1670.0 | 1341.0 | -0.523193359375 | -0.21142578125 | 0.4609375 | 0.287109375 | 0.066650390625 | -1.127685546875 | 0.2581806558574773 | 0.07521885945857812 | -1.0804929575041378 | 0.028928719142522707 | -0.008568468833578119 | -0.04719258937086224 | 0.05601276587444847 | 0.052113842342687455 | 0.02192991029503953 | 0.564688288587274 | 0 | 0 | 0 | True Negative
test_01 (2).csv | 2.019 | 1664.0 | 1344.0 | -0.701416015625 | 0.767822265625 | 0.54638671875 | 0.237060546875 | 0.01611328125 | -1.098388671875 | 0.2624268034782 | 0.07622915868175079 | -1.1729426237743965 | -0.02536625660320002 | -0.060115877431750786 | 0.07455395189939651 | 0.09907399980452086 | 0.0 | 0.025403266863486956 | 0.564688288587274 | 0 | 0 | 0 | True Negative
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
