e21199-eng/fyp-mechanosensor/docs/ESN_results/test_02_esn_results.csv

SourceFile | Time | Servo1 | Servo2 | ChassisAx | ChassisAy | ChassisAz | ActualTipAx | ActualTipAy | ActualTipAz | PredictedTipAx | PredictedTipAy | PredictedTipAz | ResidualAx | ResidualAy | ResidualAz | ResidualMagnitude | RawTouchResidual | FilteredTouchResidual | TouchThreshold | TrueTouch | DetectedTouchRaw | DetectedTouch | DetectionResult
test_02.csv | 2.0 | 1664.0 | 1344.0 | -0.827392578125 | 0.264892578125 | 0.57861328125 | 0.275634765625 | 0.0947265625 | -0.947021484375 | 0.2780168605370842 | 0.08311324569668187 | -1.1002249390090224 | -0.0023820949120841872 | 0.011613316803318133 | 0.1532034546340224 | 0.1536614526000043 | 0.0 | 0.0 | 0.564688288587274 | 0 | 0 | 0 | True Negative
test_02.csv | 2.02 | 1658.0 | 1348.0 | -0.5400390625 | 0.73291015625 | 0.752685546875 | 0.31103515625 | 0.13037109375 | -1.150390625 | 0.25105754309271594 | 0.12304473676664099 | -1.0475190264045064 | 0.05997761315728406 | 0.007326356983359011 | -0.10287159859549355 | 0.11930446506432514 | 0.11461783897583144 | 0.048232078349217486 | 0.564688288587274 | 0 | 0 | 0 | True Negative
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
