e21199-eng/fyp-mechanosensor/docs/ESN_results/test_03 (2)_esn_results.csv

SourceFile | Time | Servo1 | Servo2 | ChassisAx | ChassisAy | ChassisAz | ActualTipAx | ActualTipAy | ActualTipAz | PredictedTipAx | PredictedTipAy | PredictedTipAz | ResidualAx | ResidualAy | ResidualAz | ResidualMagnitude | RawTouchResidual | FilteredTouchResidual | TouchThreshold | TrueTouch | DetectedTouchRaw | DetectedTouch | DetectionResult
test_03 (2).csv | 2.0 | 1670.0 | 1341.0 | -0.39306640625 | -0.89306640625 | 0.5 | 0.316162109375 | 0.143798828125 | -1.048583984375 | 0.2529789783391459 | 0.11625095990616907 | -0.9965567035313956 | 0.0631831310358541 | 0.02754786821883093 | -0.05202728084360442 | 0.08635873460672795 | 0.06989442667484291 | 0.029412118512071306 | 0.564688288587274 | 0 | 0 | 0 | True Negative
test_03 (2).csv | 2.019 | 1664.0 | 1344.0 | -0.714111328125 | 0.504150390625 | 0.690185546875 | 0.29736328125 | 0.1220703125 | -1.021240234375 | 0.23713397996077304 | 0.11510996952082603 | -1.0653547608362068 | 0.06022930128922696 | 0.006960342979173972 | 0.04411452646120684 | 0.074980707872577 | 0.0 | 0.03407054044136506 | 0.564688288587274 | 0 | 0 | 0 | True Negative
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
