e21199-eng/fyp-mechanosensor/docs/ESN_results/test_04 (3)_esn_results.csv

SourceFile | Time | Servo1 | Servo2 | ChassisAx | ChassisAy | ChassisAz | ActualTipAx | ActualTipAy | ActualTipAz | PredictedTipAx | PredictedTipAy | PredictedTipAz | ResidualAx | ResidualAy | ResidualAz | ResidualMagnitude | RawTouchResidual | FilteredTouchResidual | TouchThreshold | TrueTouch | DetectedTouchRaw | DetectedTouch | DetectionResult
test_04 (3).csv | 2.0 | 1664.0 | 1344.0 | -0.662353515625 | 0.25830078125 | 0.612548828125 | 0.16552734375 | 0.48486328125 | -1.136962890625 | 0.30325807625080686 | 0.0621750991216026 | -1.192757728903317 | -0.13773073250080686 | 0.4226881821283974 | 0.055794838278317105 | 0.44804923609434 | 0.014791872047435817 | 0.006224534835925169 | 0.564688288587274 | 0 | 0 | 0 | True Negative
test_04 (3).csv | 2.019 | 1658.0 | 1348.0 | -0.5009765625 | 0.623046875 | 0.78125 | 0.13525390625 | 0.474853515625 | -1.025634765625 | 0.2887063214664424 | 0.10053537755056073 | -1.2672196713818829 | -0.15345241521644237 | 0.37431813807443926 | 0.24158490575688285 | 0.4711952662292315 | 0.0 | 0.007210404302193841 | 0.564688288587274 | 0 | 0 | 0 | True Negative
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
