e21199-eng/fyp-mechanosensor/docs/Test_data/test_01 .csv

mega_time_ms | esp_time_ms | servo1_us | servo2_us | esp_ax | esp_ay | esp_az | esp_gx | esp_gy | esp_gz | gy87_ax | gy87_ay | gy87_az | gy87_gx | gy87_gy | gy87_gz | Touch
1431 | 1541 | 1508 | 1509 | -13636 | -4740 | 7844 | -531 | -243 | -34 | 4820 | 1312 | -17460 | -279 | 69 | -155 | 0
1451 | 1561 | 1515 | 1517 | -12984 | -5140 | 7968 | -205 | -235 | 69 | 4864 | 1348 | -17296 | -398 | 196 | -140 | 0
1471 | 1581 | 1523 | 1526 | -11444 | -3440 | 7892 | -226 | -115 | 327 | 5612 | 1400 | -18828 | -716 | 522 | 12 | 0
1491 | 1601 | 1530 | 1534 | -13304 | -2652 | 8792 | -336 | -111 | 57 | 4996 | 1312 | -17748 | -697 | 0 | 405 | 0
1511 | 1621 | 1538 | 1542 | -7672 | -5840 | 9984 | -642 | 833 | 582 | 4968 | 1180 | -15776 | -255 | -561 | 80 | 0
1531 | 1641 | 1545 | 1550 | 5972 | -2836 | 10572 | -1031 | 4441 | 2468 | 5328 | 1880 | -18988 | -230 | -2478 | 1016 | 0
1551 | 1661 | 1553 | 1559 | 4800 | -4304 | 7316 | -550 | 10994 | 1503 | 4672 | 1908 | -19032 | -388 | -398 | -253 | 0
1571 | 1681 | 1560 | 1567 | -11384 | -4444 | 2112 | -1463 | 12237 | 1854 | 4032 | 856 | -18876 | -718 | -912 | -43 | 0
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
