e21199-eng/fyp-mechanosensor/docs/Test_data/test_02.csv

mega_time_ms | esp_time_ms | servo1_us | servo2_us | esp_ax | esp_ay | esp_az | esp_gx | esp_gy | esp_gz | gy87_ax | gy87_ay | gy87_az | gy87_gx | gy87_gy | gy87_gz | Touch
2779 | 1561 | 1515 | 1517 | -13176 | -2920 | 8192 | -325 | -148 | 45 | 5304 | 1608 | -17280 | -303 | 194 | -70 | 0
2799 | 1581 | 1523 | 1526 | -10016 | -2864 | 5932 | -682 | -491 | -160 | 5412 | 2060 | -18072 | -317 | 352 | -298 | 0
2819 | 1601 | 1530 | 1534 | -12112 | -4744 | 8252 | -379 | 875 | 222 | 5756 | 2132 | -15604 | 72 | 837 | -31 | 0
2839 | 1621 | 1538 | 1542 | -636 | -5648 | 8968 | -654 | 2884 | 2043 | 4764 | 2568 | -17984 | 1323 | 1882 | 1294 | 0
2859 | 1641 | 1545 | 1550 | 7260 | 2036 | 7644 | -438 | 8496 | 1504 | 5516 | 160 | -15848 | -139 | 1019 | 1427 | 0
2879 | 1661 | 1553 | 1559 | -8824 | -1296 | 3896 | -976 | 12073 | 2455 | 3740 | 3984 | -16076 | -1774 | 611 | -463 | 0
2899 | 1681 | 1560 | 1567 | -26524 | -388 | 16652 | -2771 | 9182 | 2413 | -1324 | -4528 | -6800 | -1108 | 1342 | 6631 | 0
2919 | 1701 | 1567 | 1574 | -32768 | -11904 | 5480 | -1261 | 3996 | -2286 | 5548 | 2224 | -16660 | -1213 | 833 | 3110 | 0
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
