e21199-eng/fyp-mechanosensor/docs/result new.png

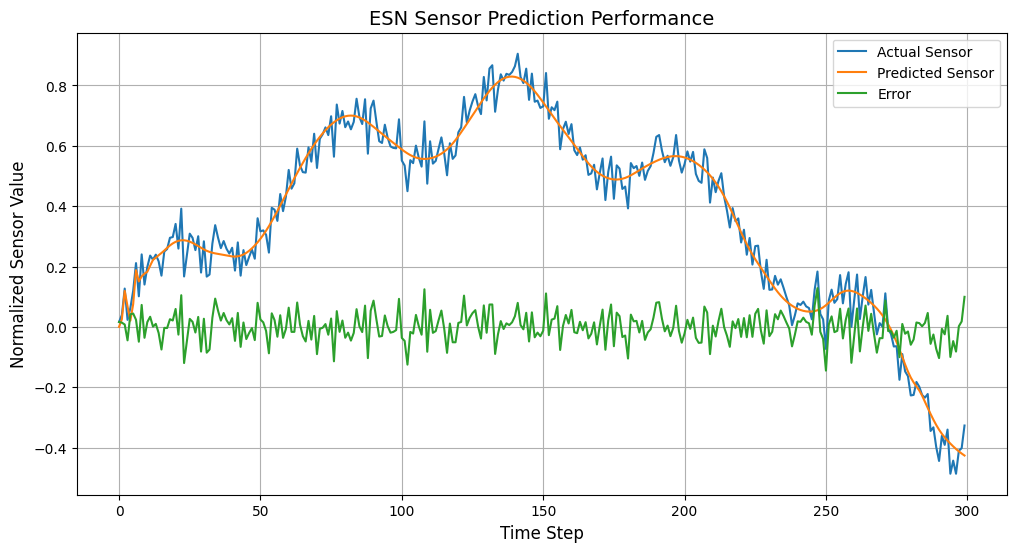
docs/result new.png
