e21199-eng/fyp-mechanosensor/docs/Mid Presentation.pdf

# CANCELLATION OFSELF-SENSING DUETO EGO-MOTION OF

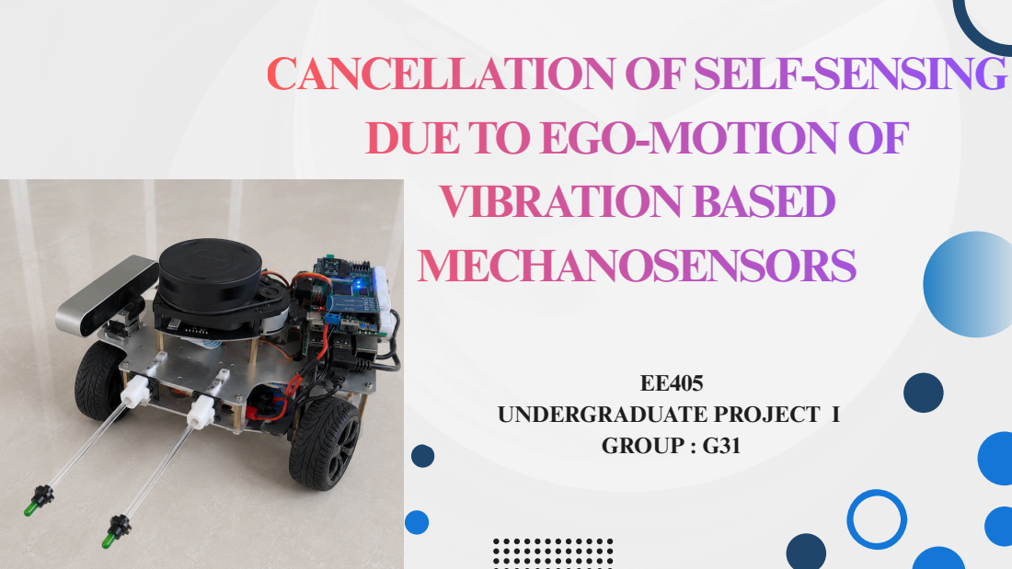
[picture p59: page 1]
VIBRATIONBASED MECHANOSENSORS; EE405 UNDERGRADUATE PROJECT I GROUP : G31

CANCELLATION OFSELF-SENSING
DUETO EGO-MOTION OF
VIBRATIONBASED
MECHANOSENSORS

# PROBLEM STATEMENT

## The Ego-Motion Problem

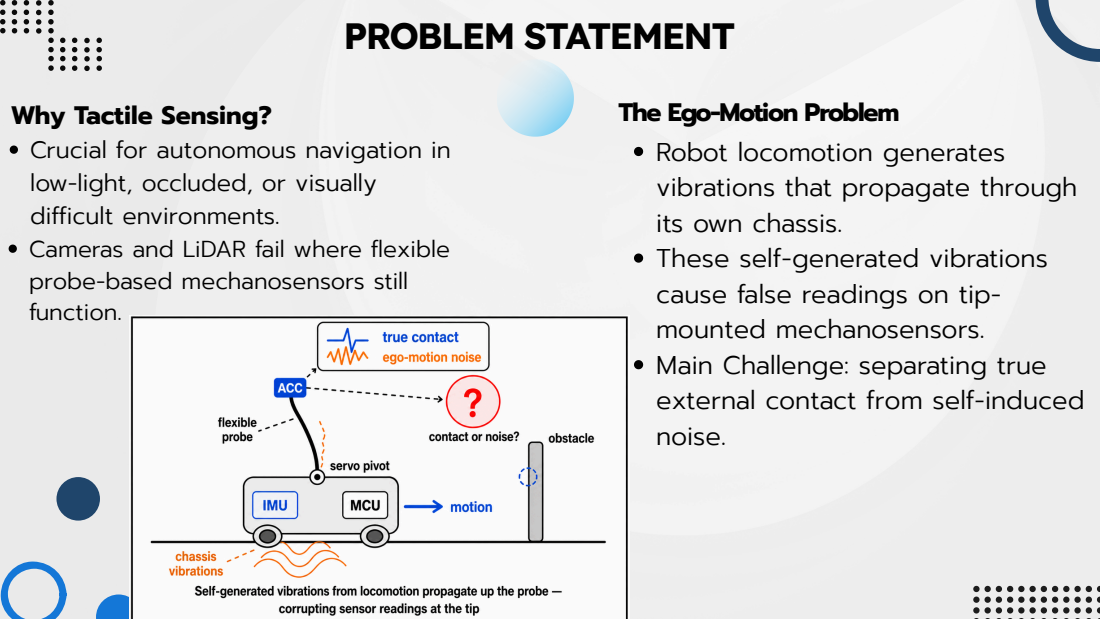
[picture p60: page 2]

Why Tactile Sensing?
Crucial for autonomous navigation in
low-light, occluded, or visually
difficult environments.
Cameras and LiDAR fail where flexible
probe-based mechanosensors still
function.

Robot locomotion generates
vibrations that propagate through
its own chassis.
These self-generated vibrations
cause false readings on tip-
mounted mechanosensors.
Main Challenge: separating true
external contact from self-induced
noise.

# PROJECT OBJECTIVES & DELIVERABLES

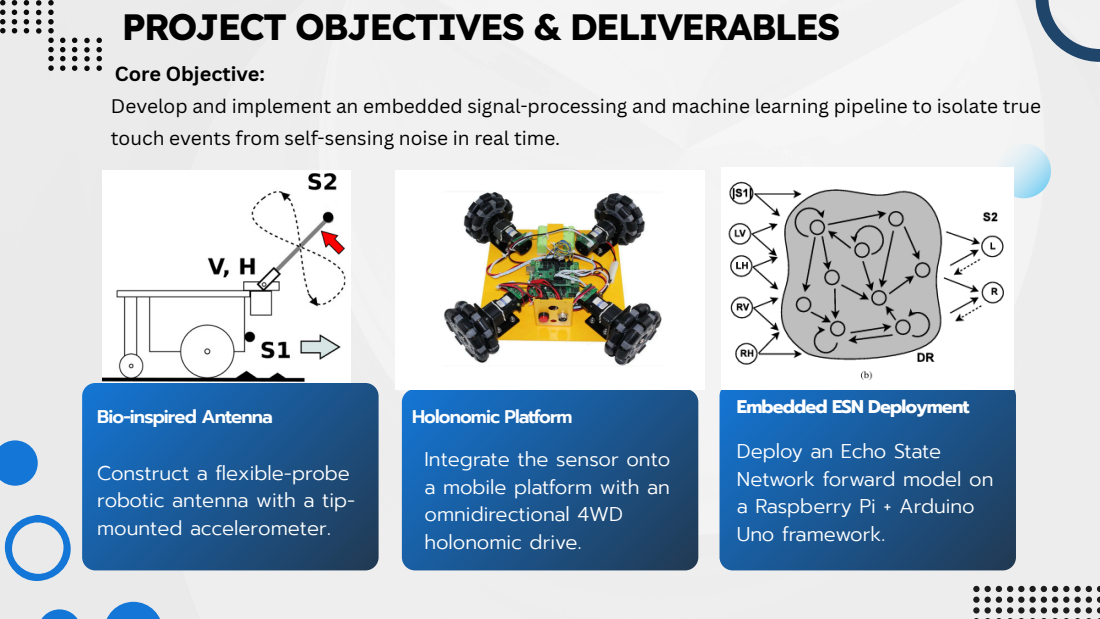
[picture p61: page 3]
Embedded ESN Deployment Bio-inspired Antenna; Holonomic Platform

Core Objective:
Develop and implement an embedded signal-processing and machine learning pipeline to isolate true
touch events from self-sensing noise in real time.

Deploy an Echo State
Network forward model on
a Raspberry Pi + Arduino
Uno framework.

Integrate the sensor onto
a mobile platform with an
omnidirectional 4WD
holonomic drive.

Construct a flexible-probe
robotic antenna with a tip-
mounted accelerometer.

# SCIENTIFIC FOUNDATIONS

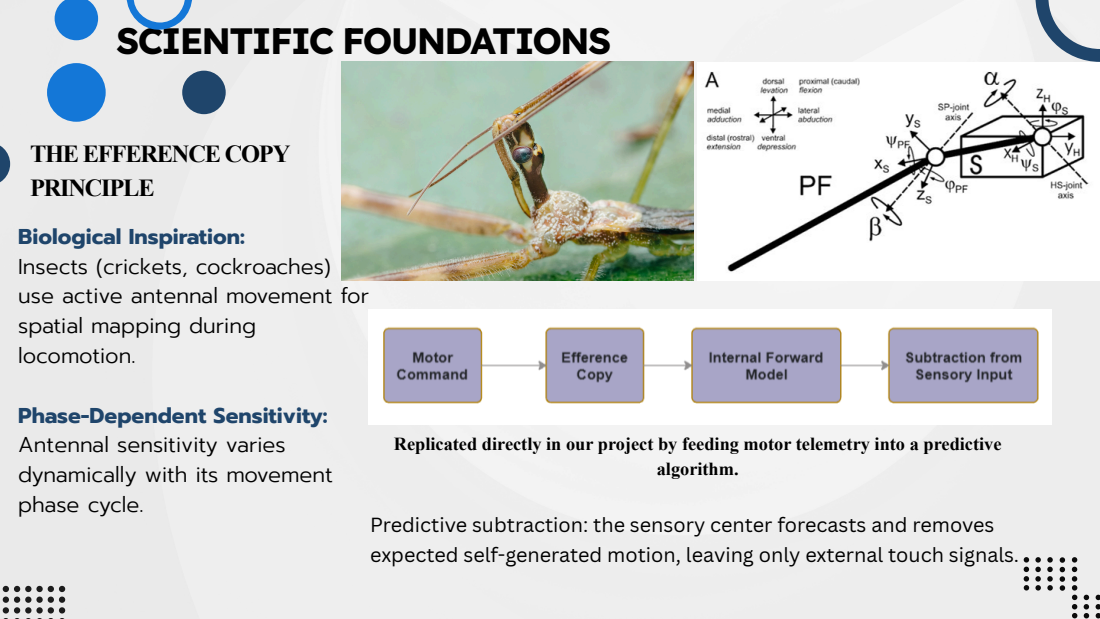
[picture p62: page 4]
algorithm.

THEEFFERENCE COPY
PRINCIPLE
Biological Inspiration:
Insects (crickets, cockroaches)
use active antennal movement for
spatial mapping during
locomotion.
Phase-Dependent Sensitivity:
Antennal sensitivity varies
dynamically with its movement
phase cycle.

Replicated directly in our project by feeding motor telemetry into a predictive

Predictive subtraction: the sensory center forecasts and removes
expected self-generated motion, leaving only external touch signals.

# CURRENT CHALLENGES IN ACTIVE SENSING

## Research Gap

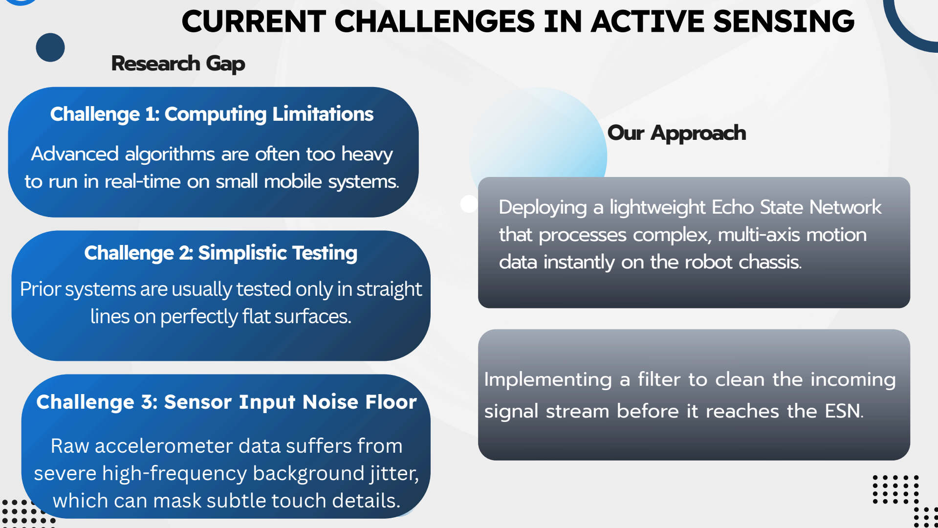
[picture p63: page 5]

### Deploying a lightweight Echo State Network that processes complex, multi-axis motion

data instantly on the robot chassis.

## Our Approach

Challenge 1: Computing Limitations

### Advanced algorithms are often too heavy

to run in real-time on small mobile systems.

### Implementing a filter to clean the incoming

signal stream before it reaches the ESN.

Challenge 2: Simplistic Testing Prior systems areusually testedonly instraight linesonperfectly flat surfaces.

Challenge 3: Sensor Input Noise Floor

Raw accelerometer data suffers from severe high-frequency background jitter, which can mask subtle touch details.

# LITERARY REVIEW: COMPARATIVE ANALYSIS

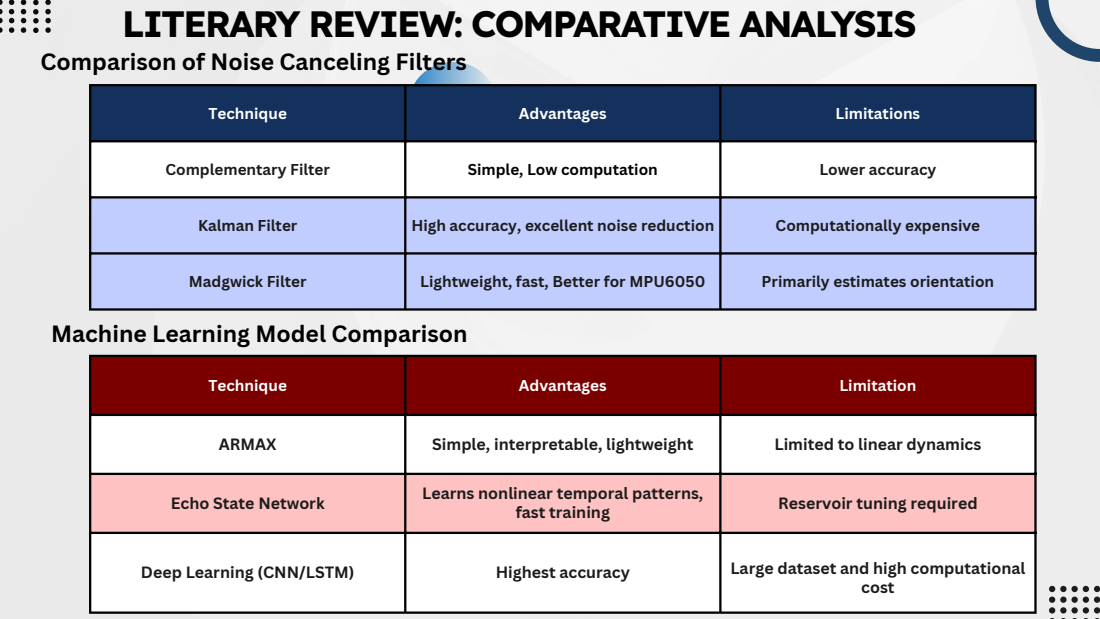
[picture p64: page 6]

Comparison of Noise Canceling Filters

Technique | Advantages | Limitations

Complementary Filter | Simple, Low computation | Lower accuracy

Kalman Filter | High accuracy, excellent noise reduction | Computationally expensive

Madgwick Filter | Lightweight, fast, Better for MPU6050 | Primarily estimates orientation

Machine Learning Model Comparison

Technique | Advantages | Limitation

ARMAX | Simple, interpretable, lightweight | Limited to linear dynamics

Echo State Network | Learns nonlinear temporal patterns, fast training | Reservoir tuning required

Deep Learning (CNN/LSTM) | Highest accuracy | Large dataset and high computational cost

# PROPOSED METHODOLOGY & ARCHITECTURE

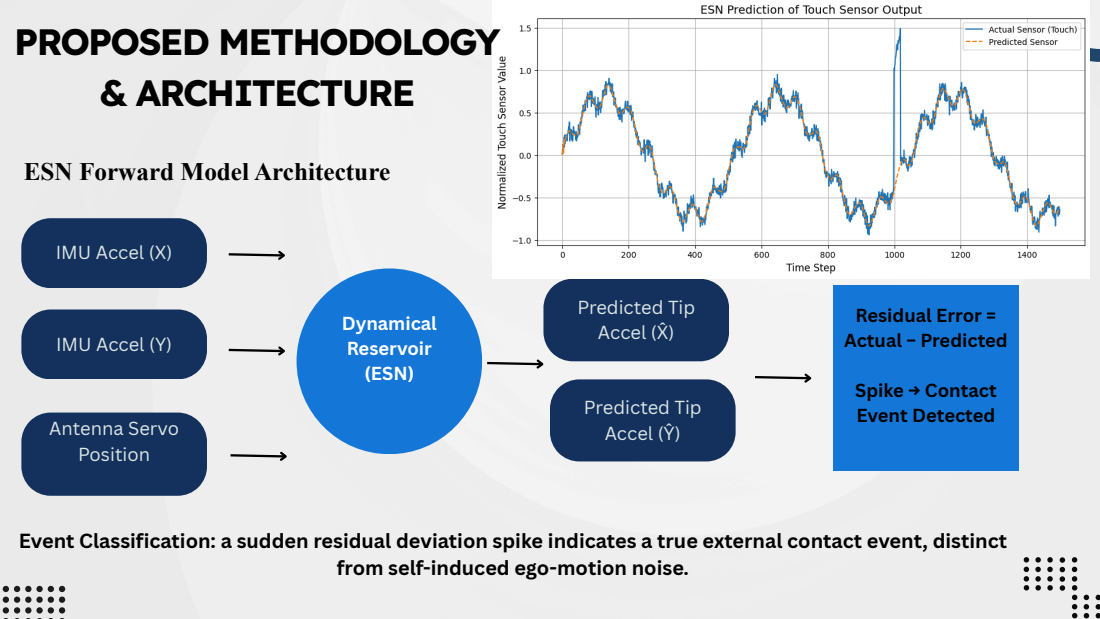
[picture p65: page 7]
Dynamical Reservoir (ESN); IMU Accel (X); IMU Accel (Y); Antenna Servo Position; Predicted Tip Accel (X̂); Predicted Tip Accel (Ŷ); Residual Error = Actual − Predicted; Spike → Contact Event Detected

ESN Forward Model Architecture

Event Classification: a sudden residual deviation spike indicates a true external contact event, distinct

from self-induced ego-motion noise.

## Sensing Nodes

# IMPLEMENTATION FRAMEWORK &

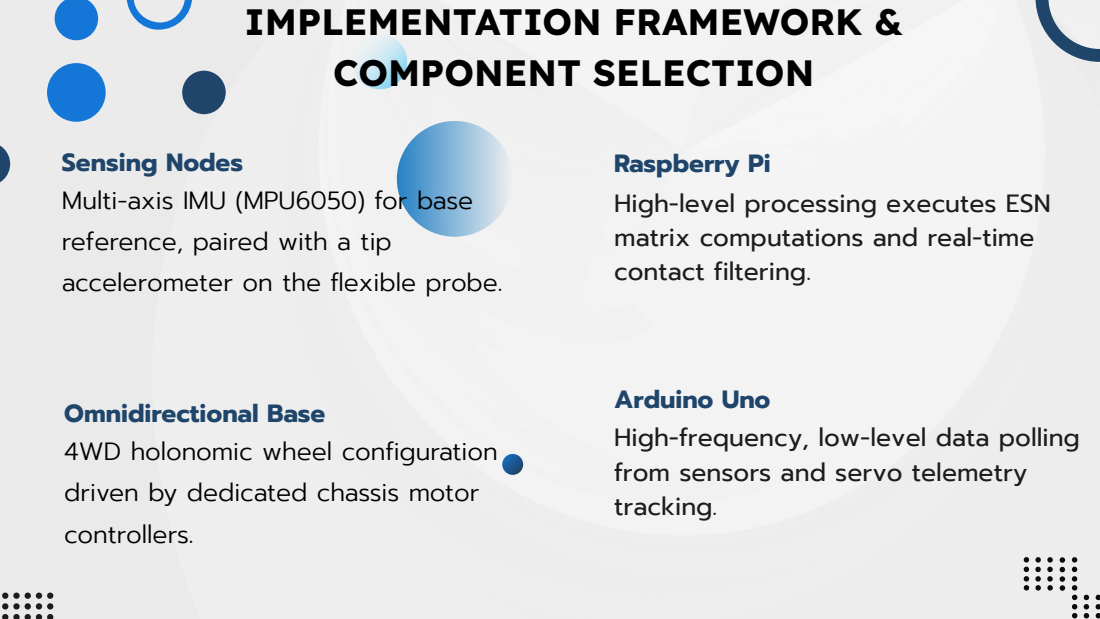
[picture p66: page 8]
COMPONENT SELECTION

Raspberry Pi
High-level processing executes ESN
matrix computations and real-time
contact filtering.

Multi-axis IMU (MPU6050) for base
reference, paired with a tip
accelerometer on the flexible probe.

Arduino Uno
High-frequency, low-level data polling
from sensors and servo telemetry
tracking.

Omnidirectional Base
4WD holonomic wheel configuration
driven by dedicated chassis motor
controllers.

# IMPLEMENTATION FRAMEWORK & COMPONENT SELECTION

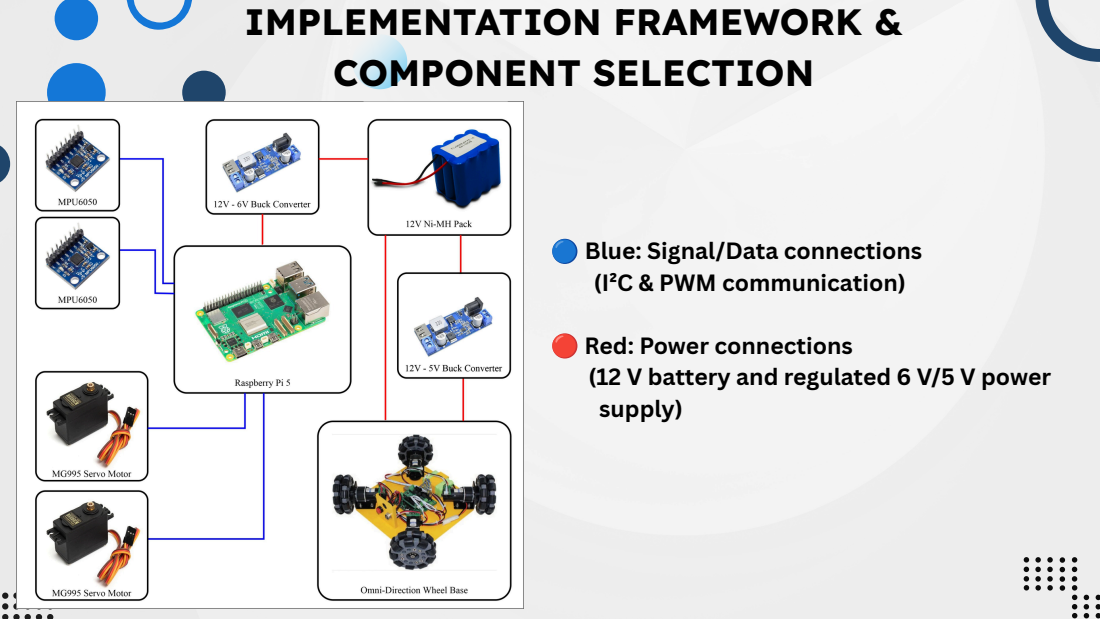
[picture p67: page 9]

🔵 Blue: Signal/Data connections
(I²C & PWM communication)

🔴 Red: Power connections
(12 V battery and regulated 6 V/5 V power
supply)

# PROJECT PLAN & MID-SEMESTER MILESTONES

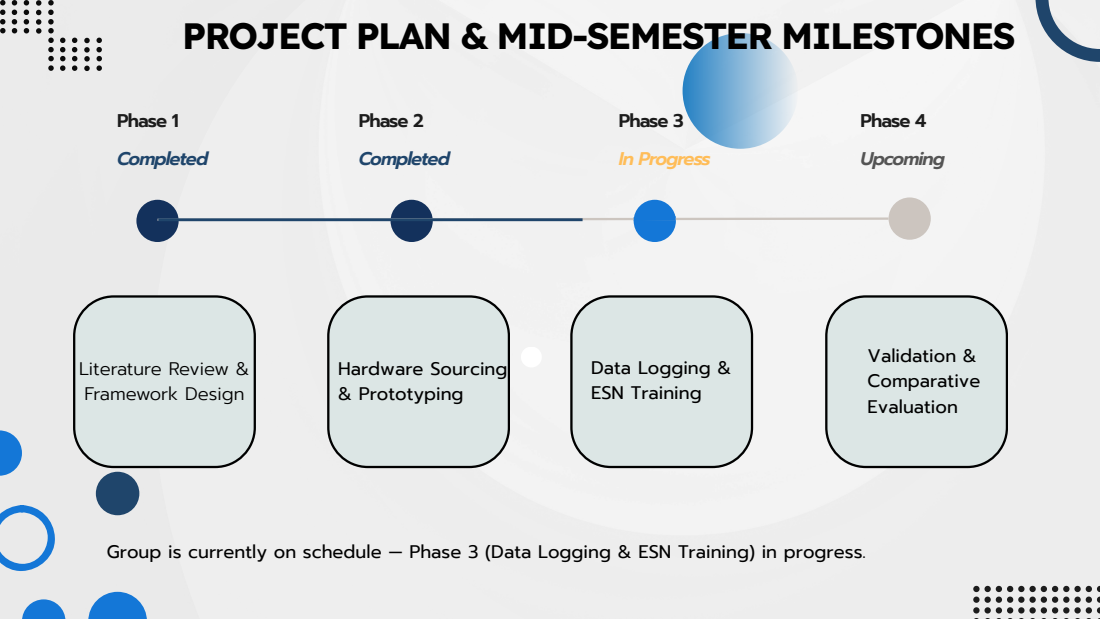
[picture p68: page 10]
Literature Review & Framework Design; Phase 1; Phase 2; Phase 3; Phase 4; Completed; In Progress; Upcoming; Hardware Sourcing & Prototyping; Data Logging & ESN Training; Validation & Comparative Evaluation

Group is currently on schedule — Phase 3 (Data Logging & ESN Training) in progress.

# Gantt Chart

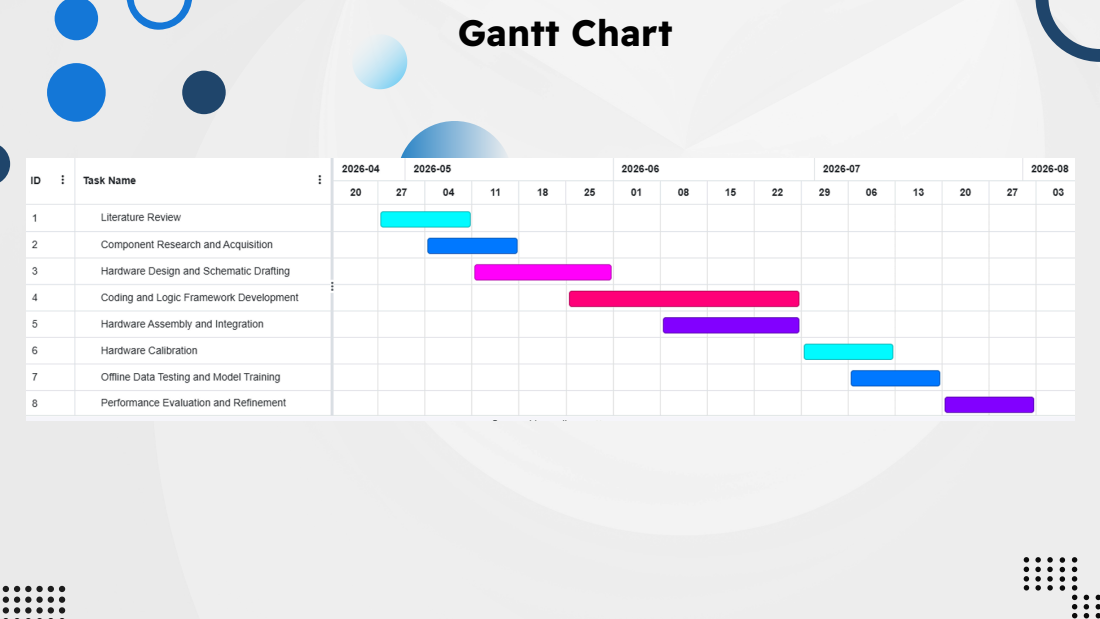
[picture p69: page 11]

# CURRENT PROGRESS & PRELIMINARY EVALUATION

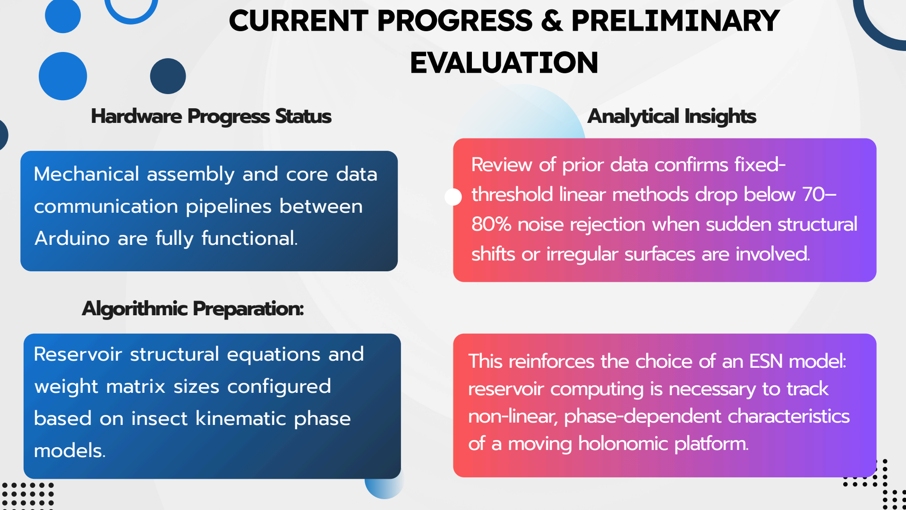
[picture p70: page 12]

## Hardware Progress Status

### Review of prior data confirms fixedthreshold linear methods drop below 70– 80% noise rejection when sudden structural

shifts or irregular surfaces are involved.

## Analytical Insights

## Algorithmic Preparation:

### Reservoir structural equations and weight matrix sizes configured based on insect kinematic phase

models.

### This reinforces the choice of an ESN model: reservoir computing is necessary to track non-linear, phase-dependent characteristics

of a moving holonomic platform.

### Mechanical assembly and core data communication pipelines between

Arduino are fully functional.

# OBSERVATIONS/RESULTS

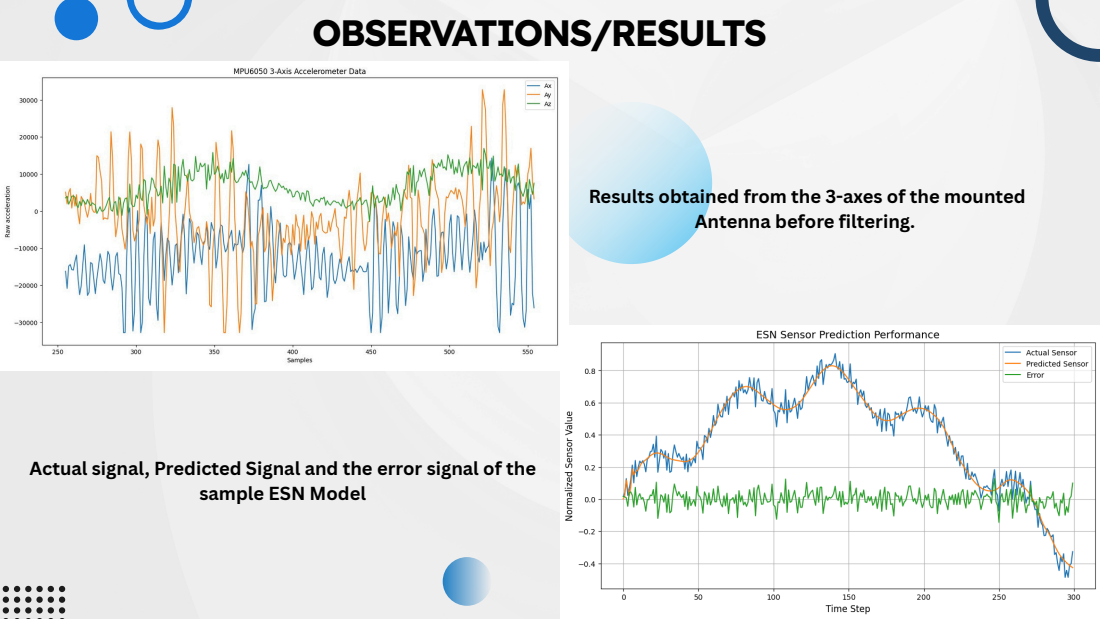
[picture p71: page 13]

Results obtained from the 3-axes of the mounted

Antenna before filtering.

Actual signal, Predicted Signal and the error signal of the

sample ESN Model

# CONCLUSIONS & FUTURE MILESTONES

## Preliminary Conclusion:

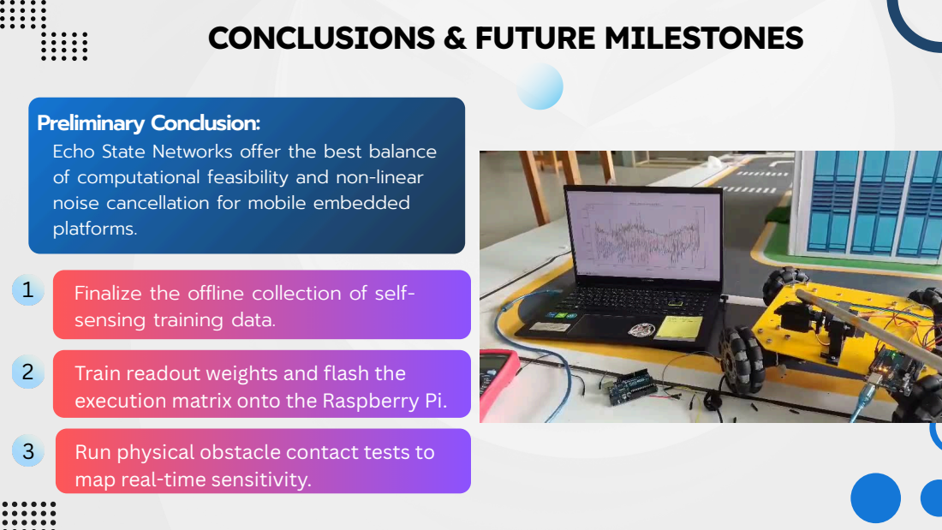
[picture p72: page 14]
Run physical obstacle contact tests to

Echo State Networks offer the best balance
of computational feasibility and non-linear
noise cancellation for mobile embedded
platforms.

Finalize the offline collection of self-
sensing training data.

Train readout weights and flash the
execution matrix onto the Raspberry Pi.

map real-time sensitivity.

# DELIVERABLES AND REFERENCES

Deliverables:
1.Literature Review:
https://drive.google.com/file/d/1Scmkz3GoWBiHw4eQhIUktYzD0q_mwWXN/view?usp=drive_link 2.Component Selection Report: https://drive.google.com/file/d/1BPZq4nTgJhvT8DZAA7GpHTTjUrYqxoGK/view?usp=drive_link 1.Design Diagrams:
https://drive.google.com/file/d/1HqHS5aSH8MO8N4h5fhMfL4LpMrXgkYGe/view?usp=drive_link
2. Codes:
Platform: https://drive.google.com/drive/folders/1JL1JS3Xzwc0cGVFVBLCdJ0xM6NcnPURm?usp=drive_link (https://drive.google.com/drive/folders/1JL1JS3Xzwc0cGVFVBLCdJ0xM6NcnPURm?usp=drive_link)
Accelerometer Data Acquisition: https://drive.google.com/drive/folders/1aTZ0R2Bjfa_SXAcO-WrGmnUUu1FQrULW?usp=drive_link (https://drive.google.com/drive/folders/1aTZ0R2Bjfa_SXAcO-WrGmnUUu1FQrULW?usp=drive_link)
ESN: https://colab.research.google.com/drive/1guCraSH6m98zCZfai44IAiscpB1u0_Dr?

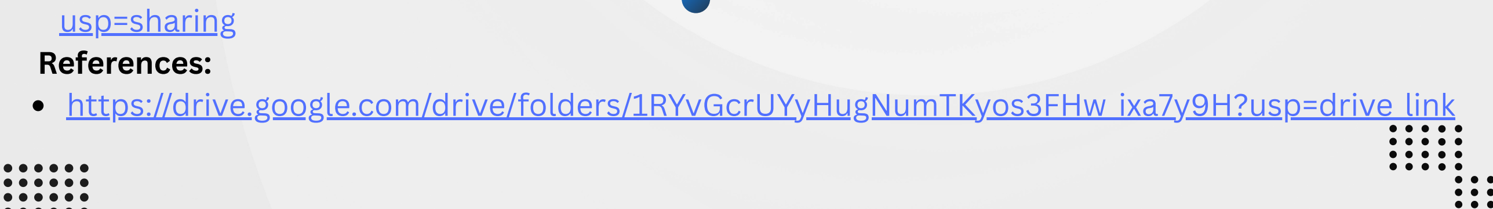
[picture p73: figure]
usp=sharing References: https://drive.google.com/drive/folders/1RYvGcrUYyHugNumTKyos3FHw_ixa7y9H?usp=drive_link

# THANK

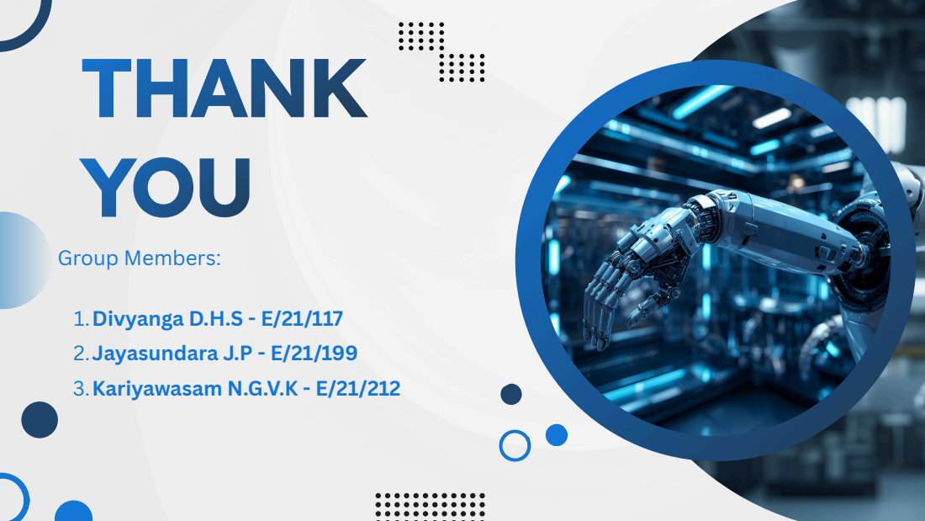
[picture p74: page 16]
YOU; Group Members:; 1.Divyanga D.H.S - E/21/117 2.Jayasundara J.P - E/21/199 3.Kariyawasam N.G.V.K - E/21/212
